Red-Lucy-Engineering/scarlet-8088/renders/scarlet-8088-rev10-front.png

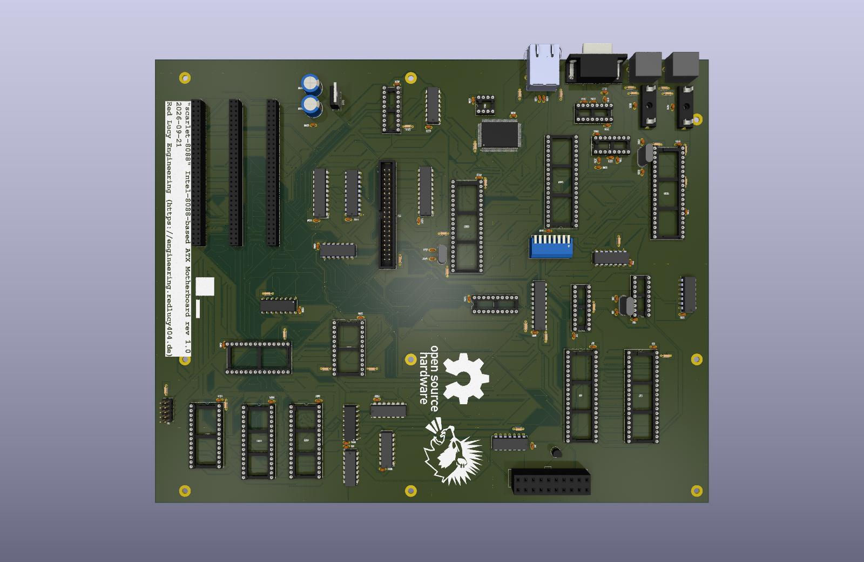
renders/scarlet-8088-rev10-front.png
