Red-Lucy-Engineering/scarlet-8088/README.md

# "scarlet-8088": Intel 8088-based ATX motherboard
