Red-Lucy-Engineering/scarlet-8088/extra/Mini-DIN6-Footprint/Mini-DIN-6P.step

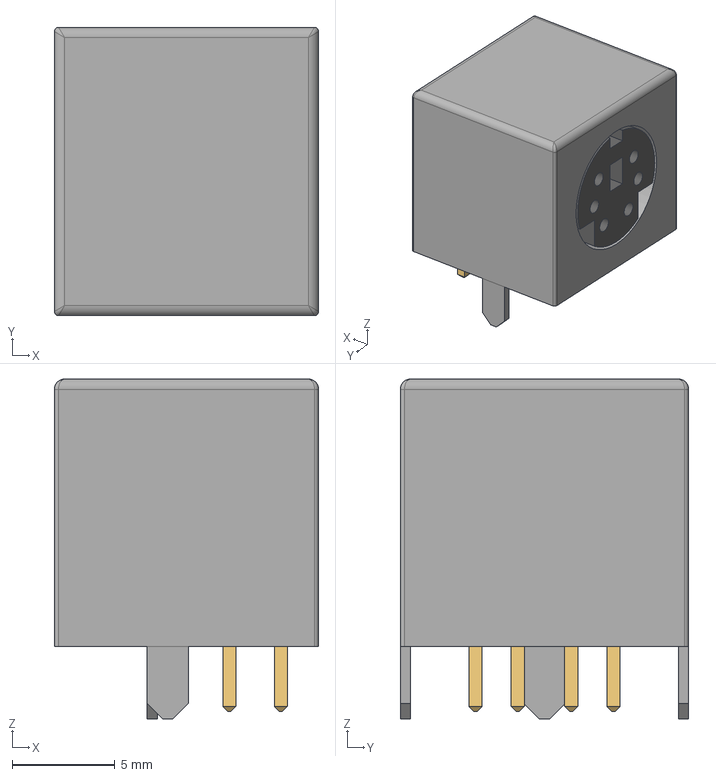
[picture p4: CAD file, 2026-09-21]
extra/Mini-DIN6-Footprint/Mini-DIN-6P.step
12.8 x 14.0 x 16.5 mm
