Red-Lucy-Engineering/scarlet-8088/extra/RJMG1BD3B8K1ANR/RJMG1BD3B8K1ANR--3DModel-STEP-56544.STEP

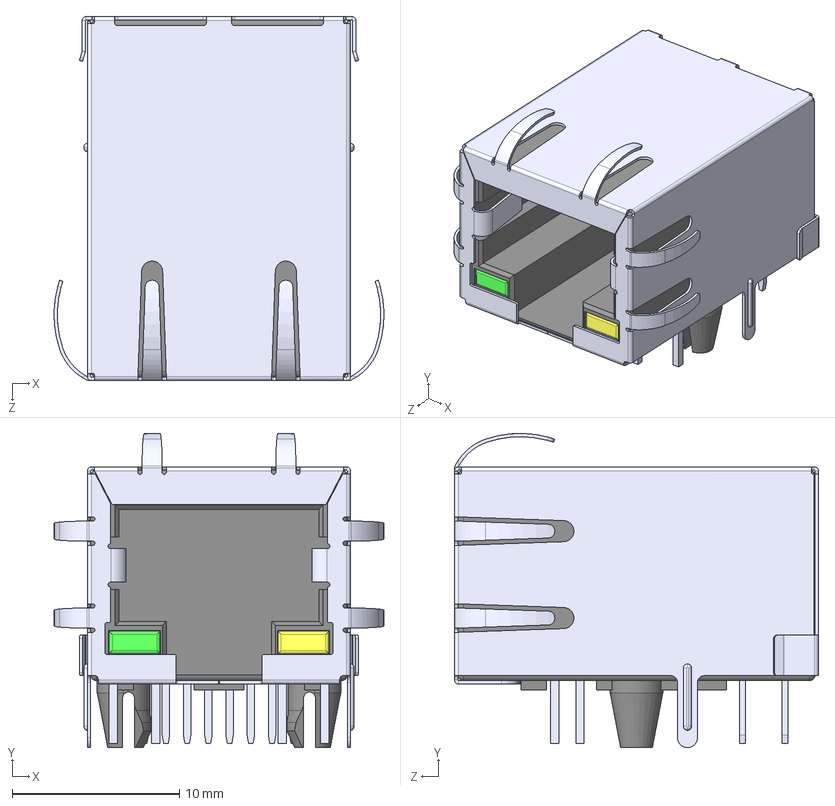
[picture p5: CAD file, 2026-09-21]
extra/RJMG1BD3B8K1ANR/RJMG1BD3B8K1ANR--3DModel-STEP-56544.STEP
19.7 x 18.8 x 21.8 mm
