Red-Lucy-Engineering/scarlet-8088/schematics/scarlet-8088.pdf

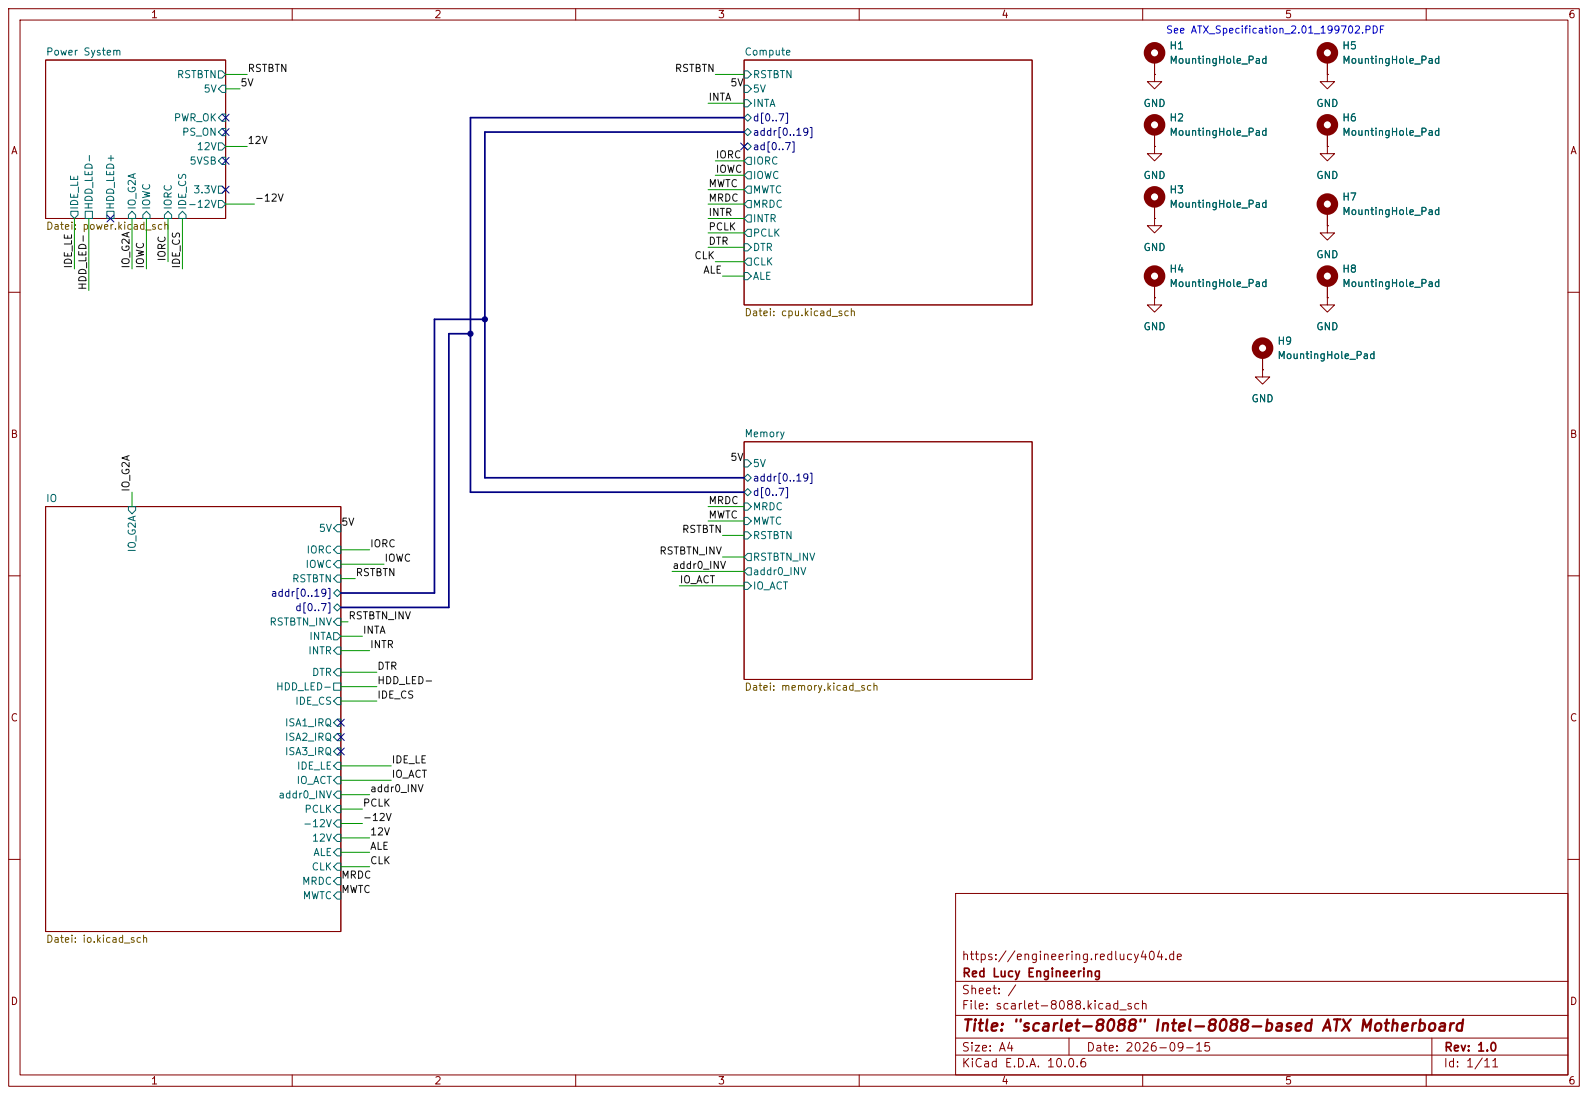
[picture p6: page 1]

ALE CLK MRDC MWTC

https://engineering.redlucy404.de
Red Lucy Engineering
Sheet: /
File: scarlet-8088.kicad_sch
Title: "scarlet-8088" Intel-8088-based ATX Motherboard

Size: A4 | Rev: 1.0
KiCad E.D.A. 10.0.6 | Id: 1/11

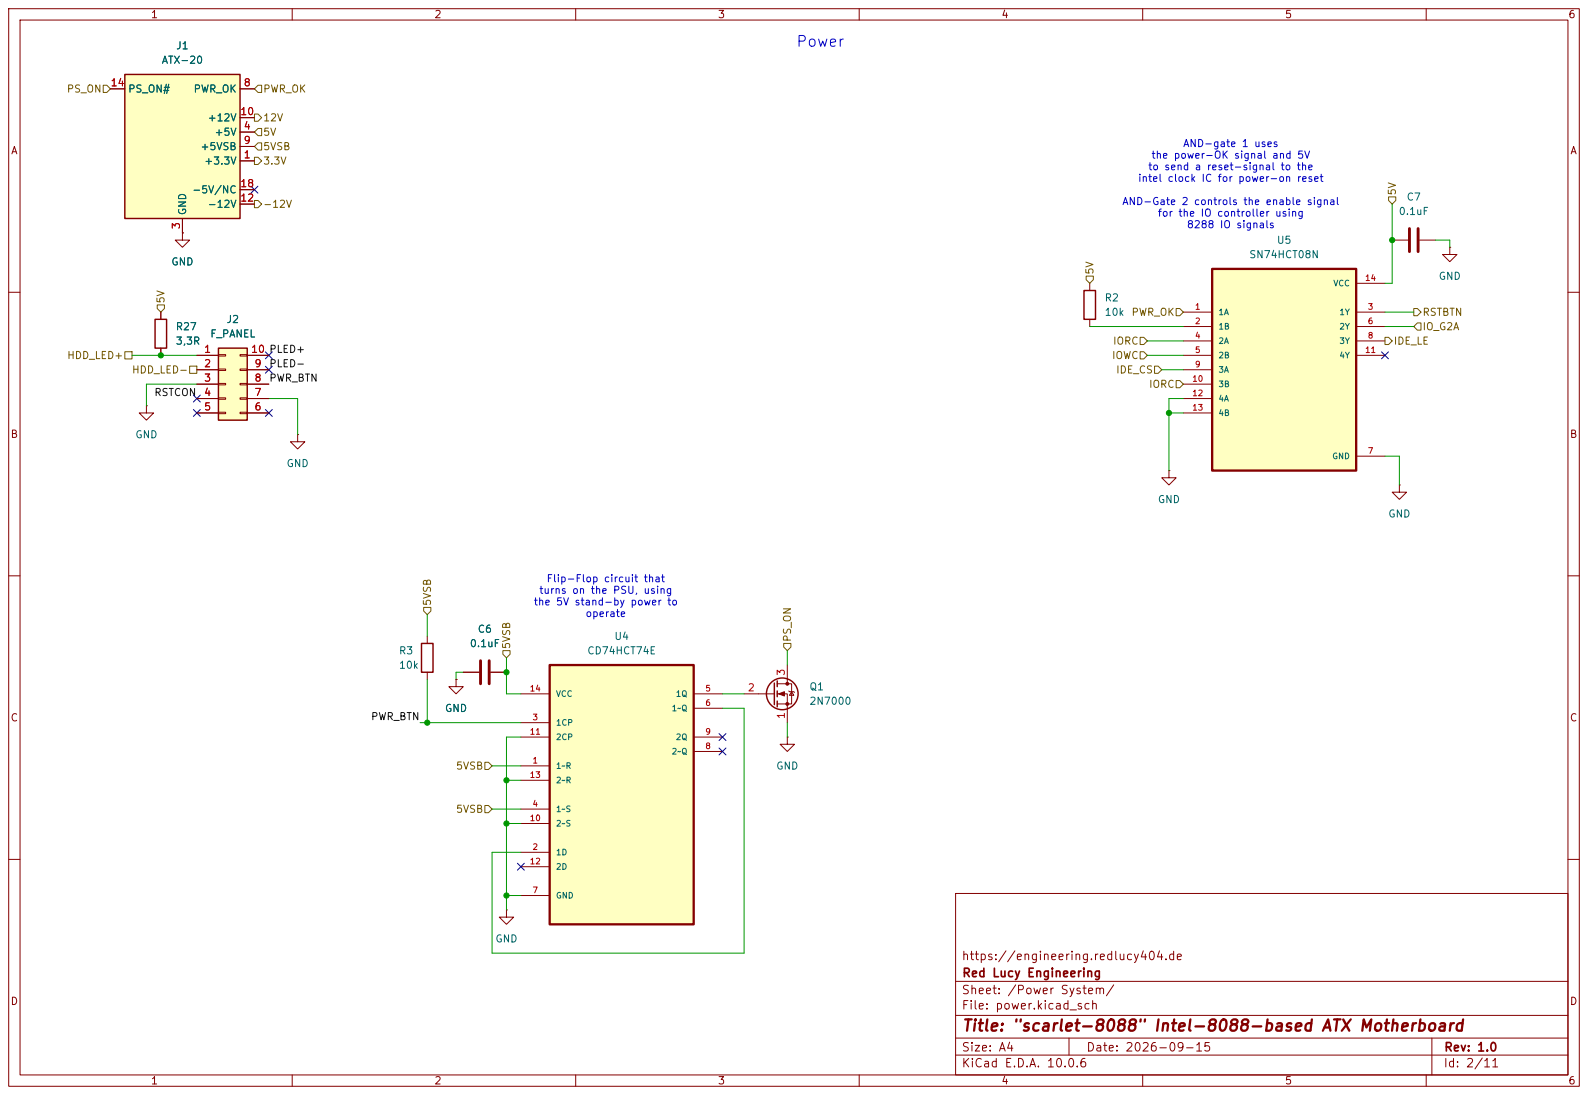
[picture p7: page 2]

AND-gate 1 uses
the power-OK signal and 5V
to send a reset-signal to the

intel clock IC for power-on reset AND-Gate 2 controls the enable signal for the IO controller using 8288 IO signals C6

Flip-Flop circuit that
turns on the PSU, using
the 5V stand-by power to

https://engineering.redlucy404.de
Red Lucy Engineering
Sheet: /Power System/
File: power.kicad_sch
Title: "scarlet-8088" Intel-8088-based ATX Motherboard

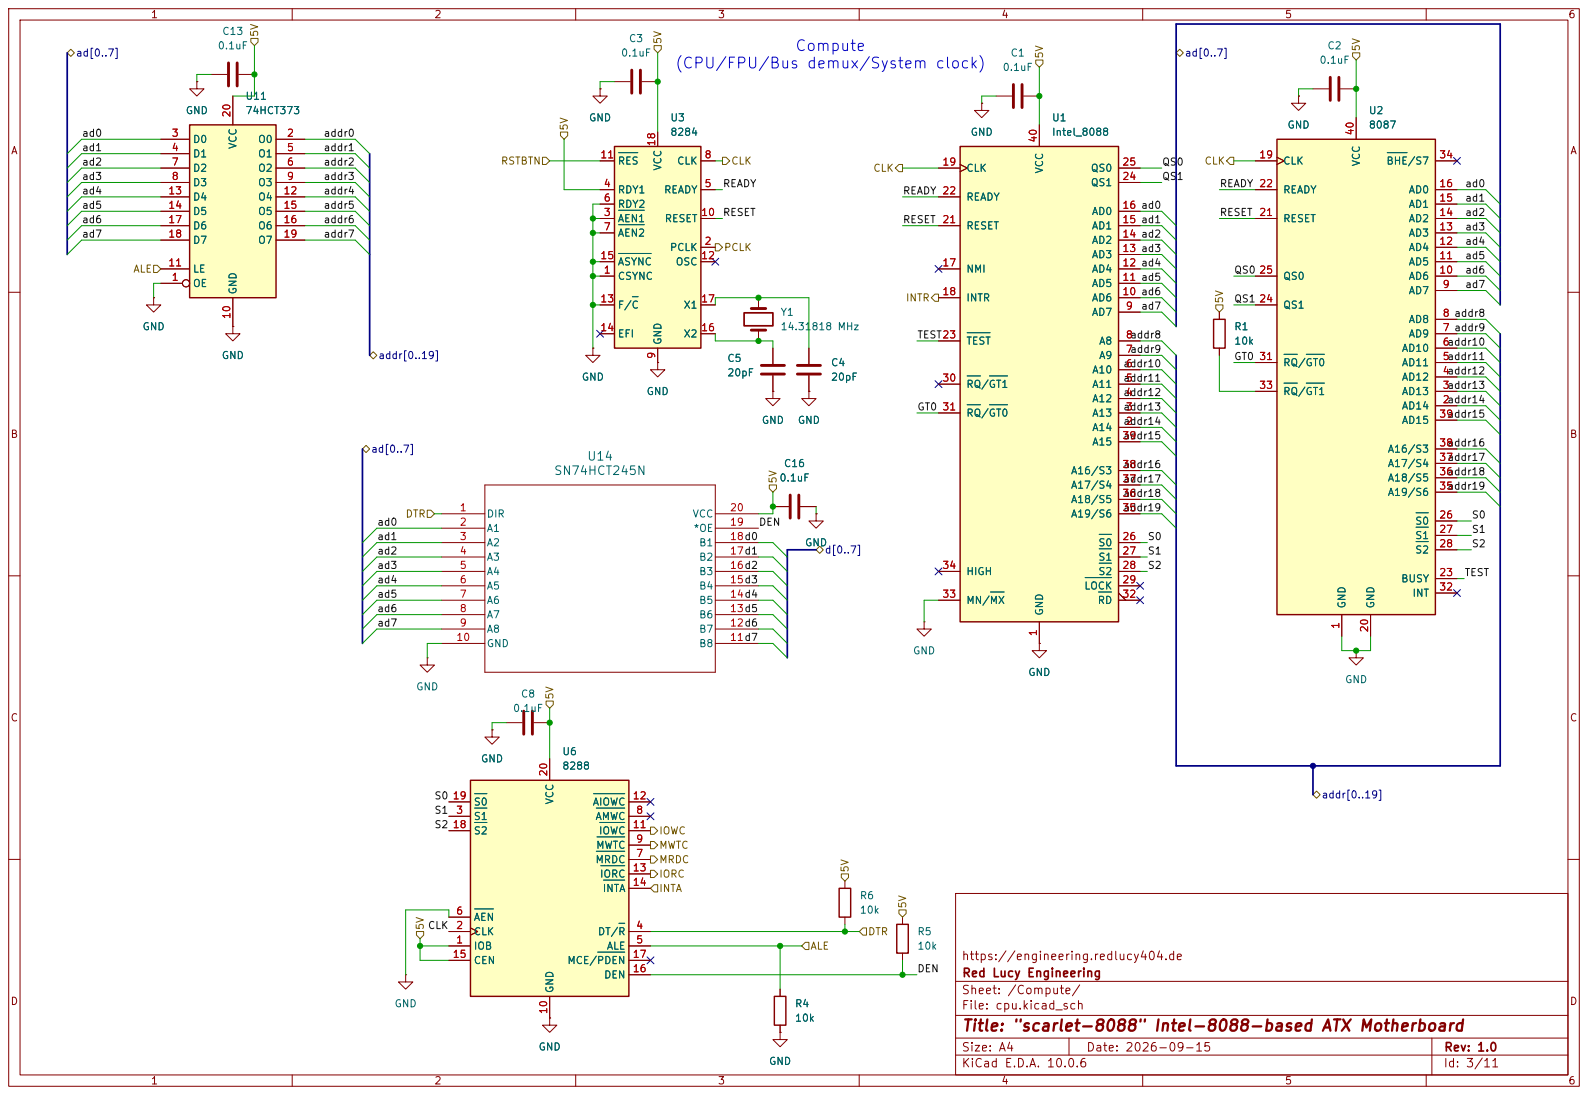
[picture p8: page 3]

(CPU/FPU/Bus demux/System clock)

https://engineering.redlucy404.de
Red Lucy Engineering
Sheet: /Compute/
File: cpu.kicad_sch
Title: "scarlet-8088" Intel-8088-based ATX Motherboard

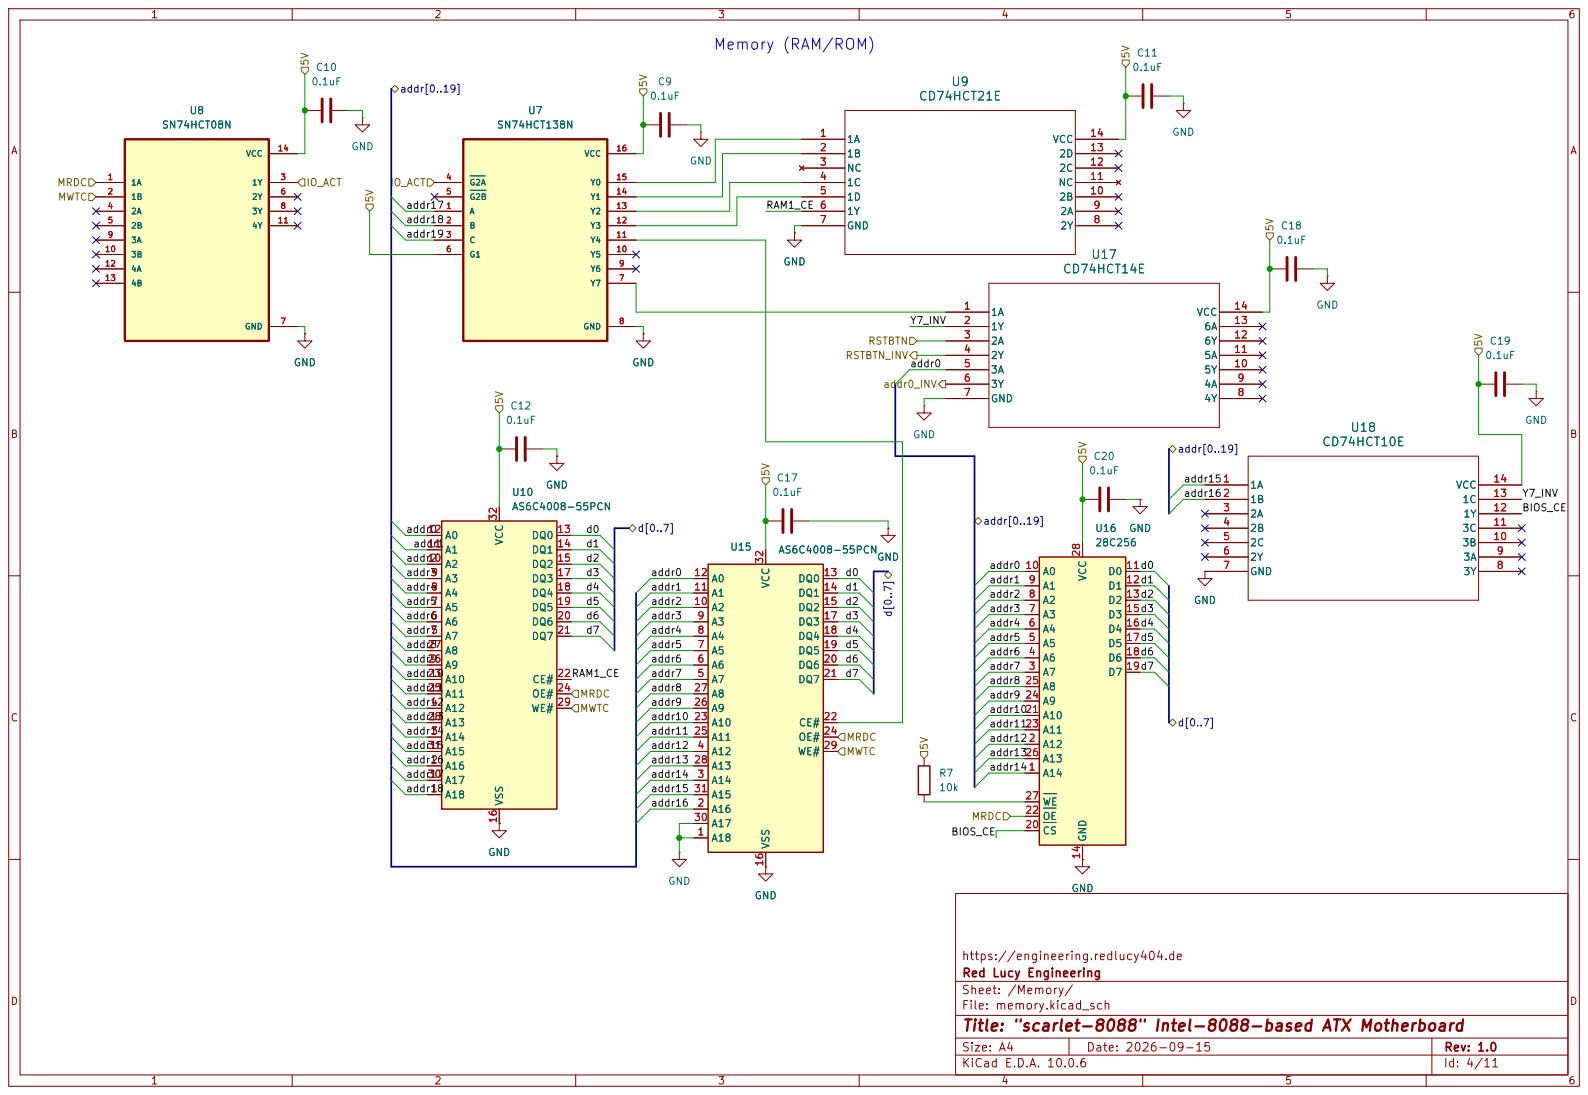
[picture p9: page 4]

https://engineering.redlucy404.de
Red Lucy Engineering
Sheet: /Memory/
File: memory.kicad_sch
Title: "scarlet-8088" Intel-8088-based ATX Motherboard

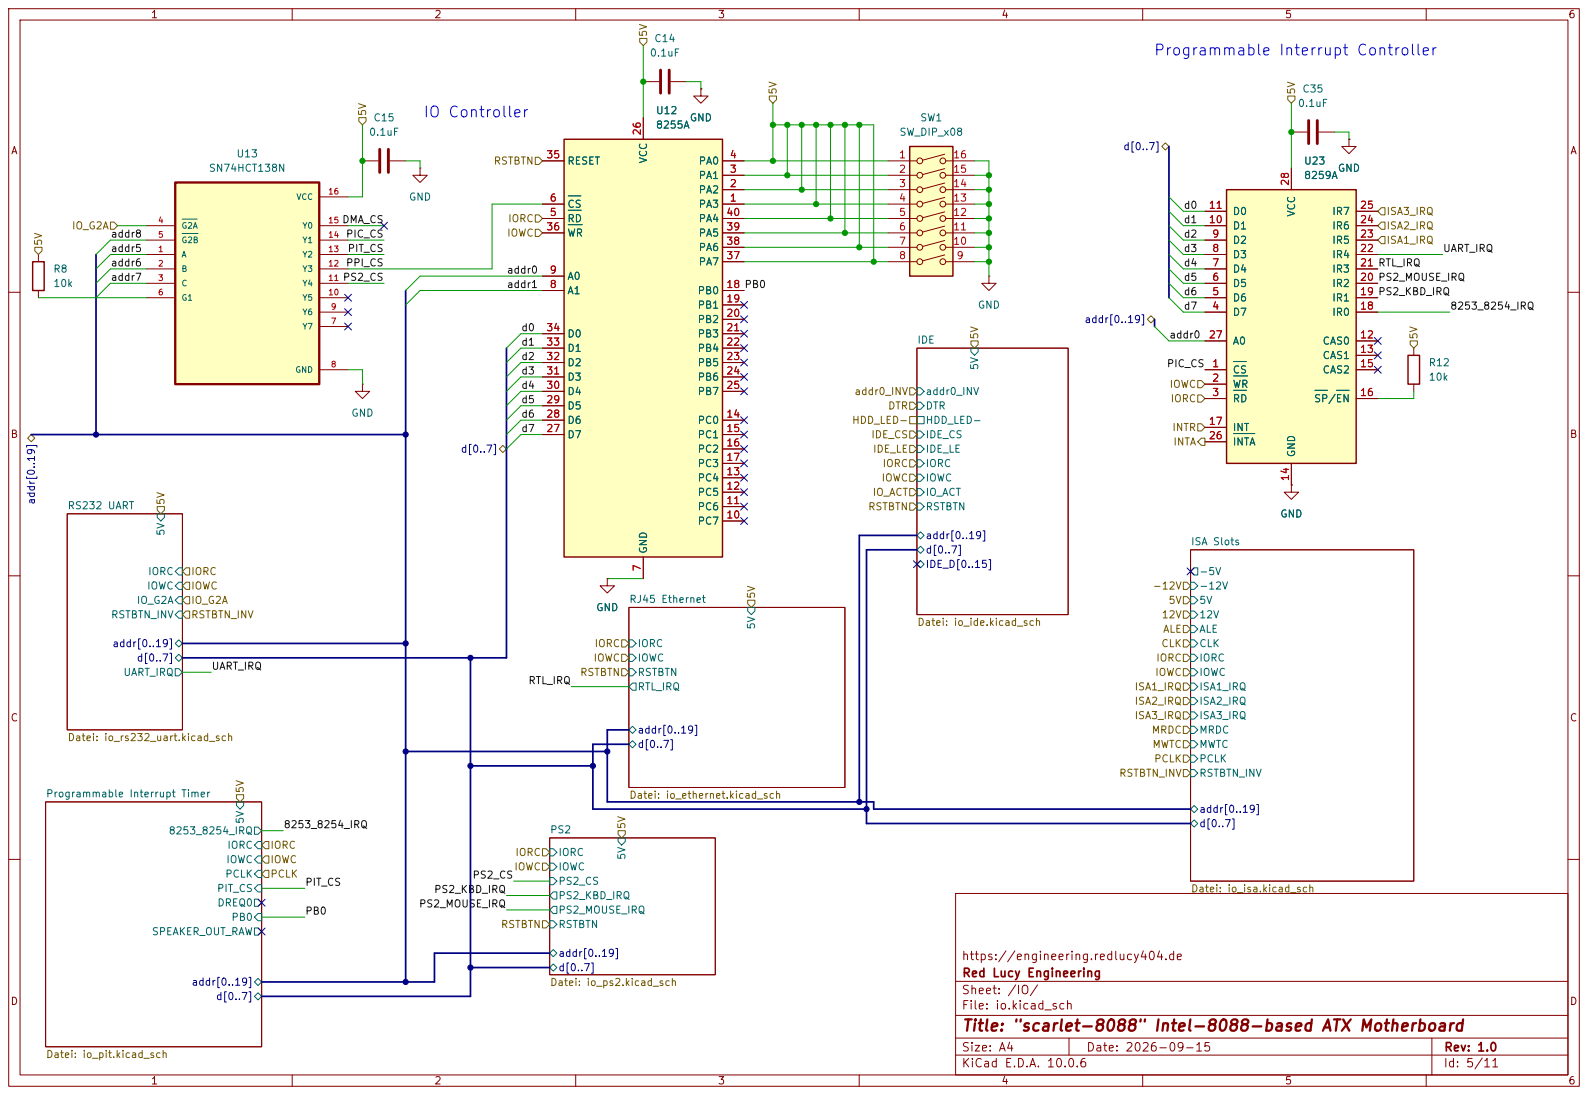
[picture p10: page 5]

6 | ALE 5V

ISA Slots Datei: io_isa.kicad_sch 5V addr0_INV DTR HDD_LED-

https://engineering.redlucy404.de
Red Lucy Engineering
Sheet: /IO/
File: io.kicad_sch
Title: "scarlet-8088" Intel-8088-based ATX Motherboard

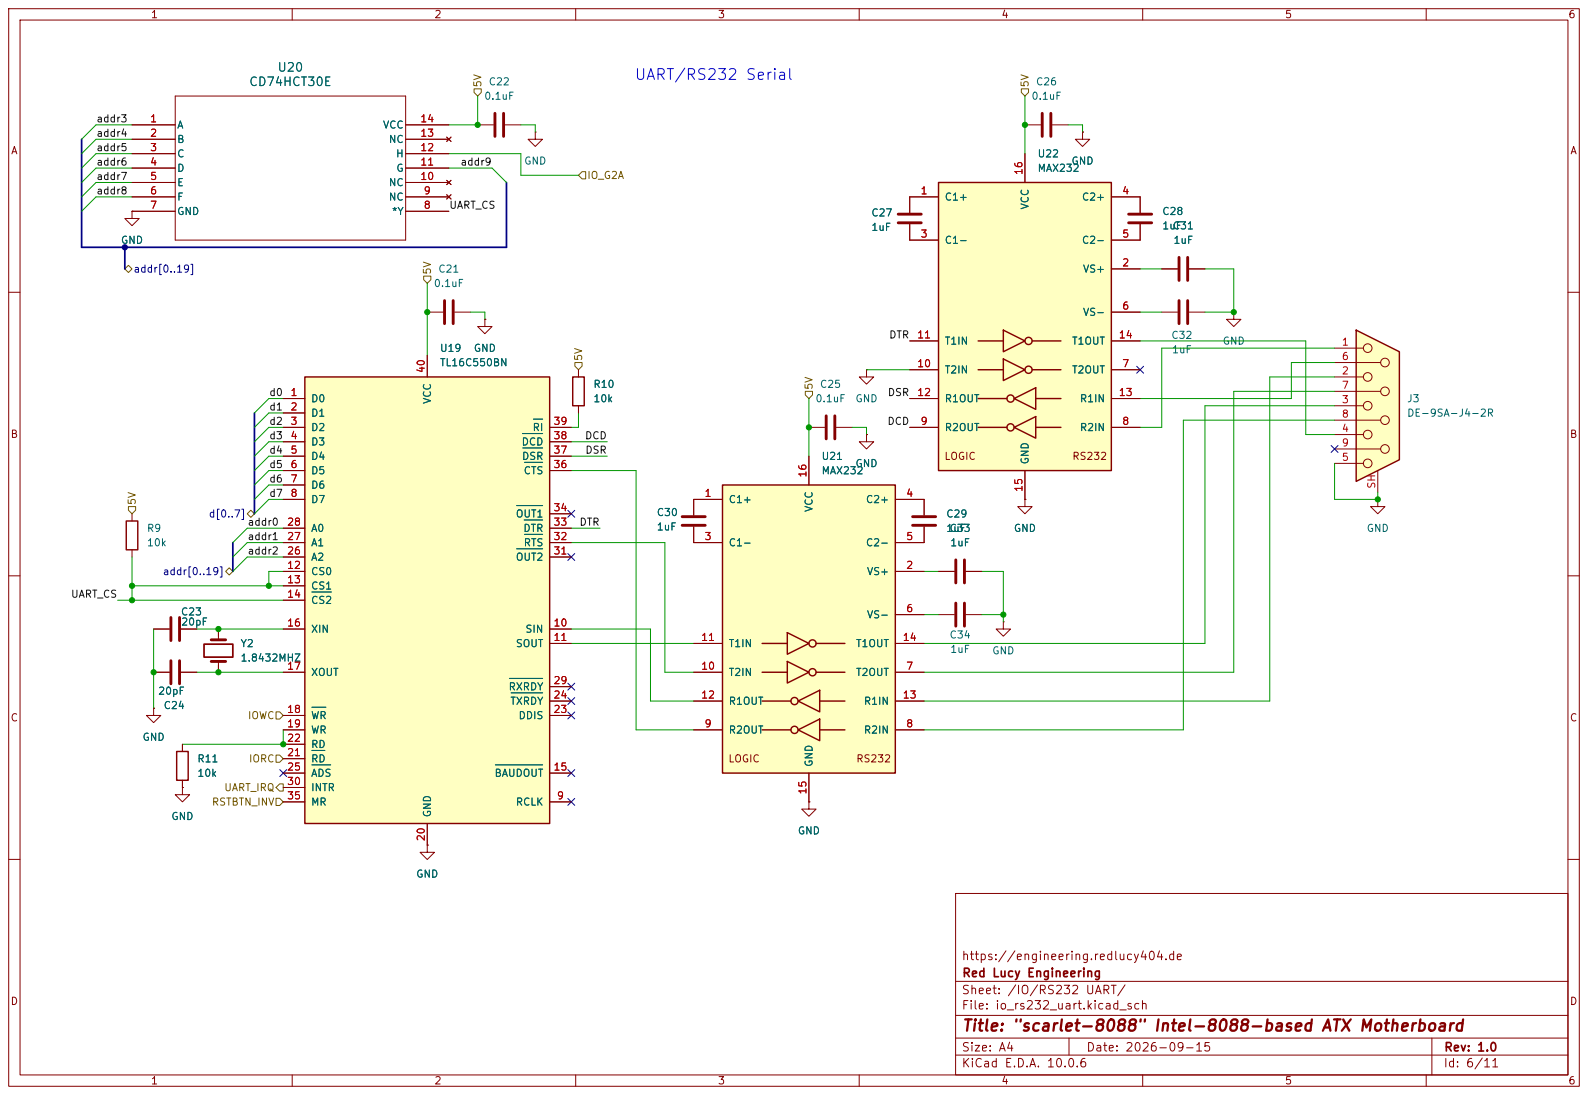
[picture p11: page 6]

https://engineering.redlucy404.de
Red Lucy Engineering
Sheet: /IO/RS232 UART/
File: io_rs232_uart.kicad_sch
Title: "scarlet-8088" Intel-8088-based ATX Motherboard

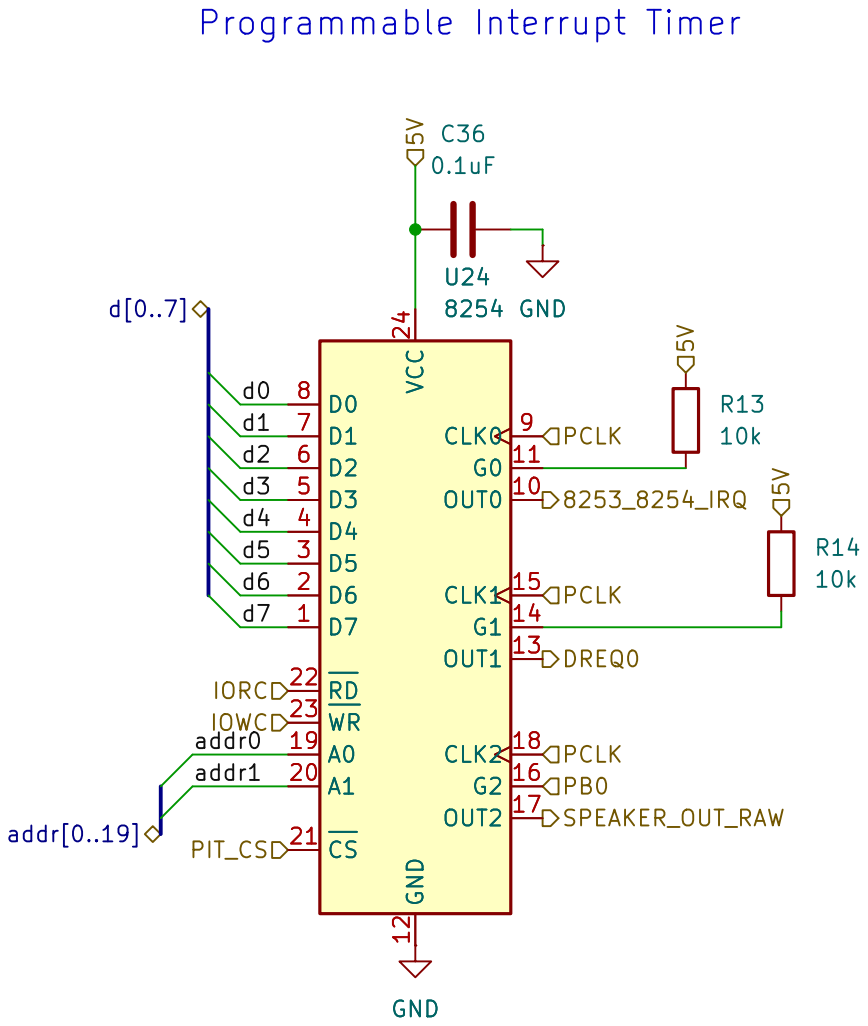
[picture p12: page 7]

https://engineering.redlucy404.de
Red Lucy Engineering
Sheet: /IO/Programmable Interrupt Timer/
File: io_pit.kicad_sch
Title: "scarlet-8088" Intel-8088-based ATX Motherboard

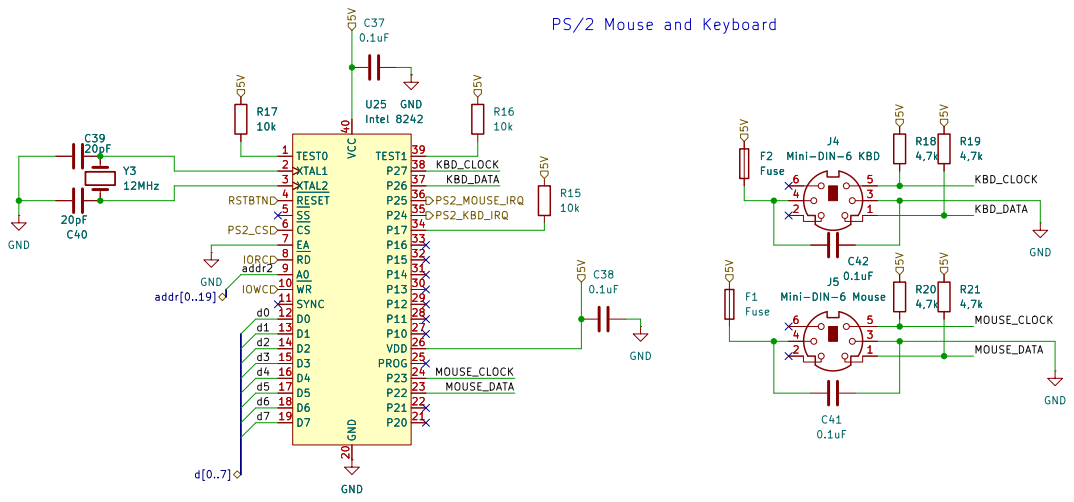
[picture p13: page 8]

https://engineering.redlucy404.de
Red Lucy Engineering
Sheet: /IO/PS2/
File: io_ps2.kicad_sch
Title: "scarlet-8088" Intel-8088-based ATX Motherboard

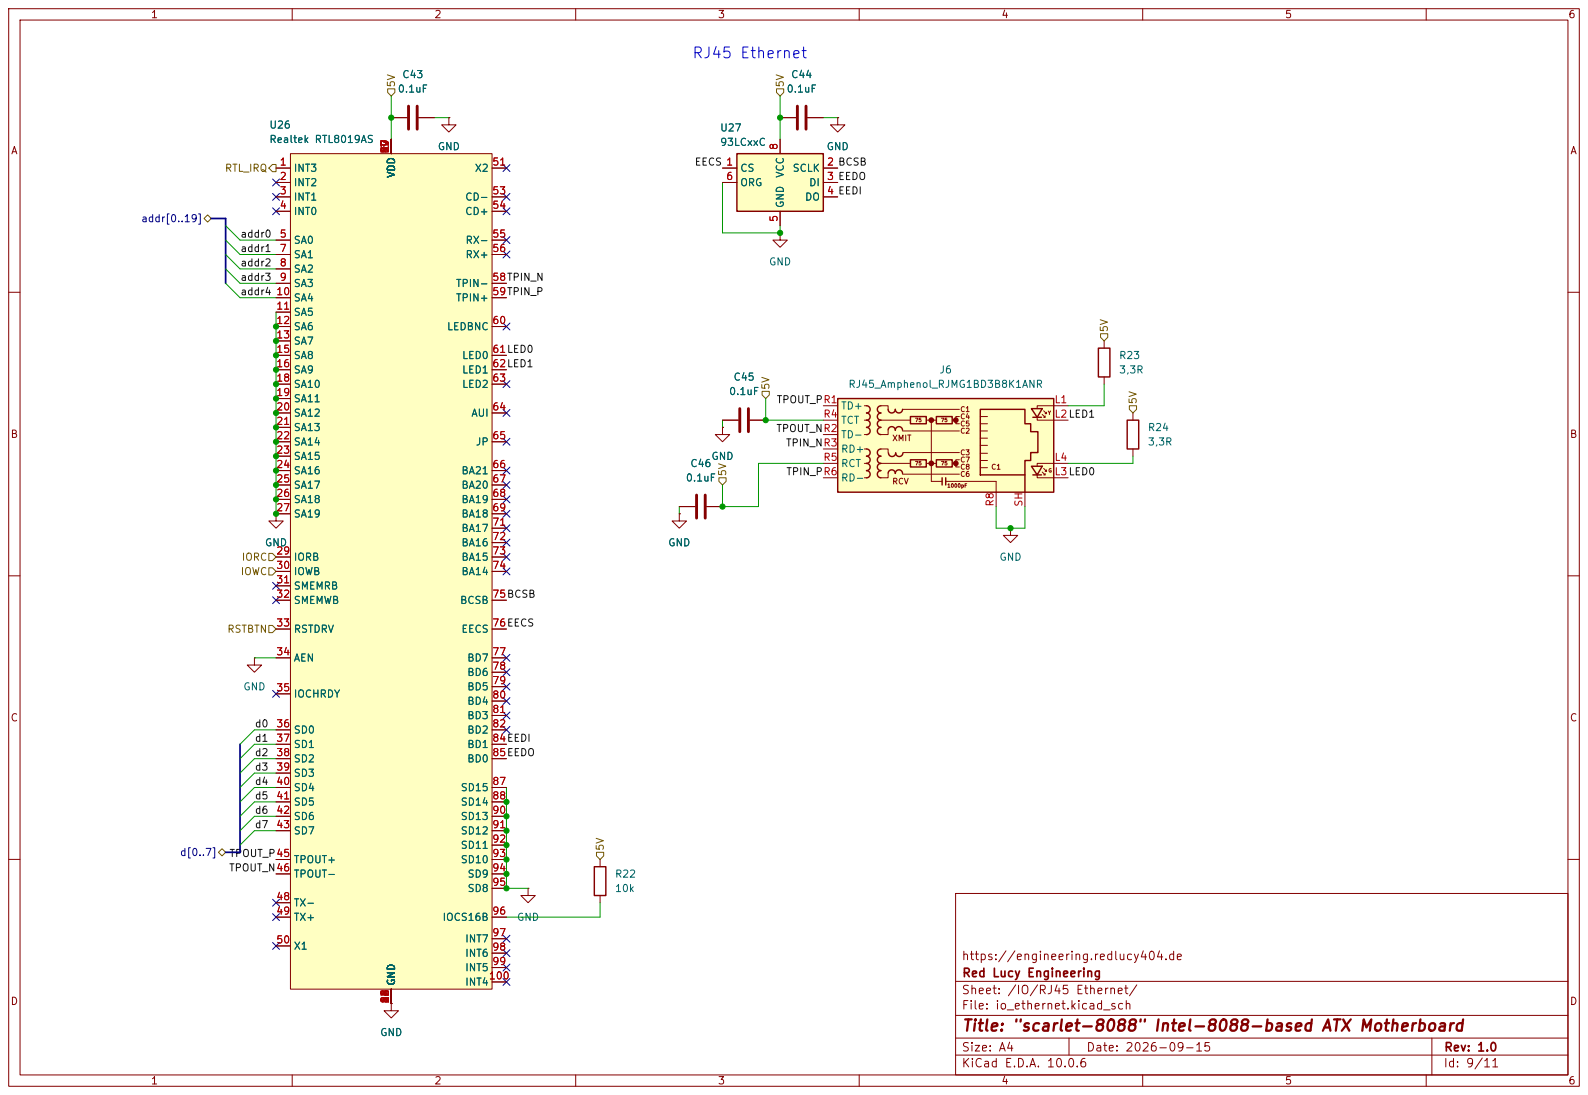
[picture p14: page 9]

https://engineering.redlucy404.de
Red Lucy Engineering
Sheet: /IO/RJ45 Ethernet/
File: io_ethernet.kicad_sch
Title: "scarlet-8088" Intel-8088-based ATX Motherboard

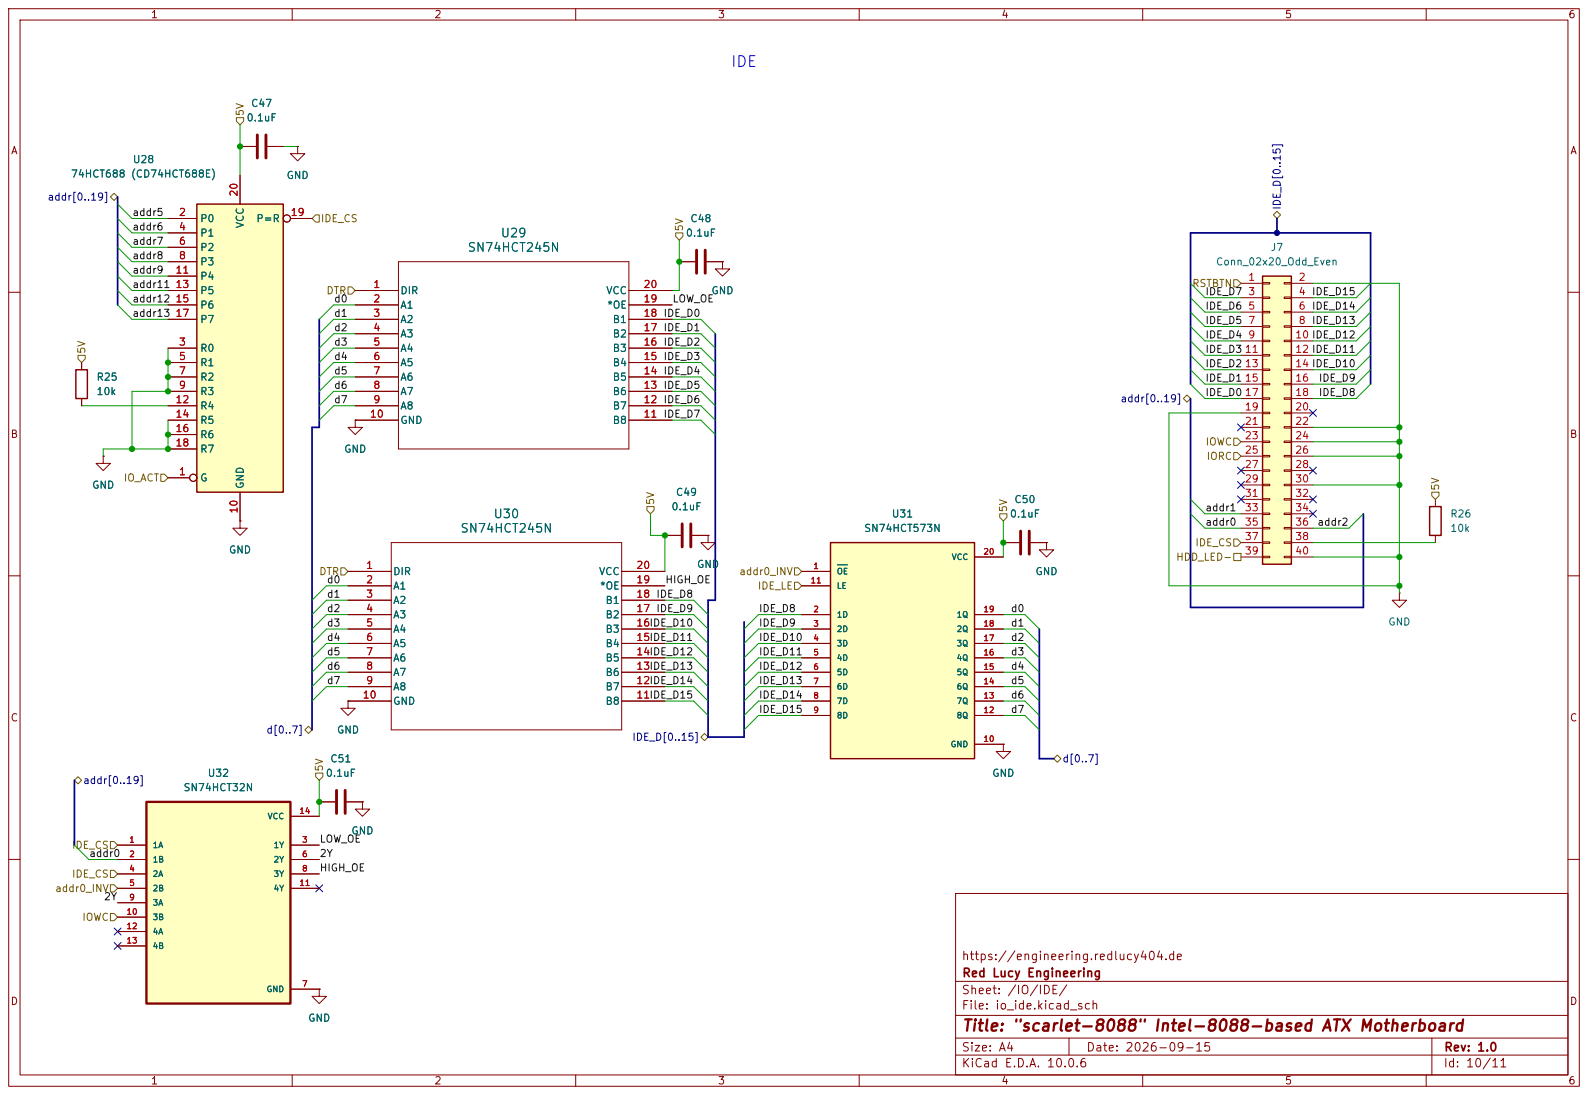
[picture p15: page 10]

https://engineering.redlucy404.de
Red Lucy Engineering
Sheet: /IO/IDE/
File: io_ide.kicad_sch
Title: "scarlet-8088" Intel-8088-based ATX Motherboard

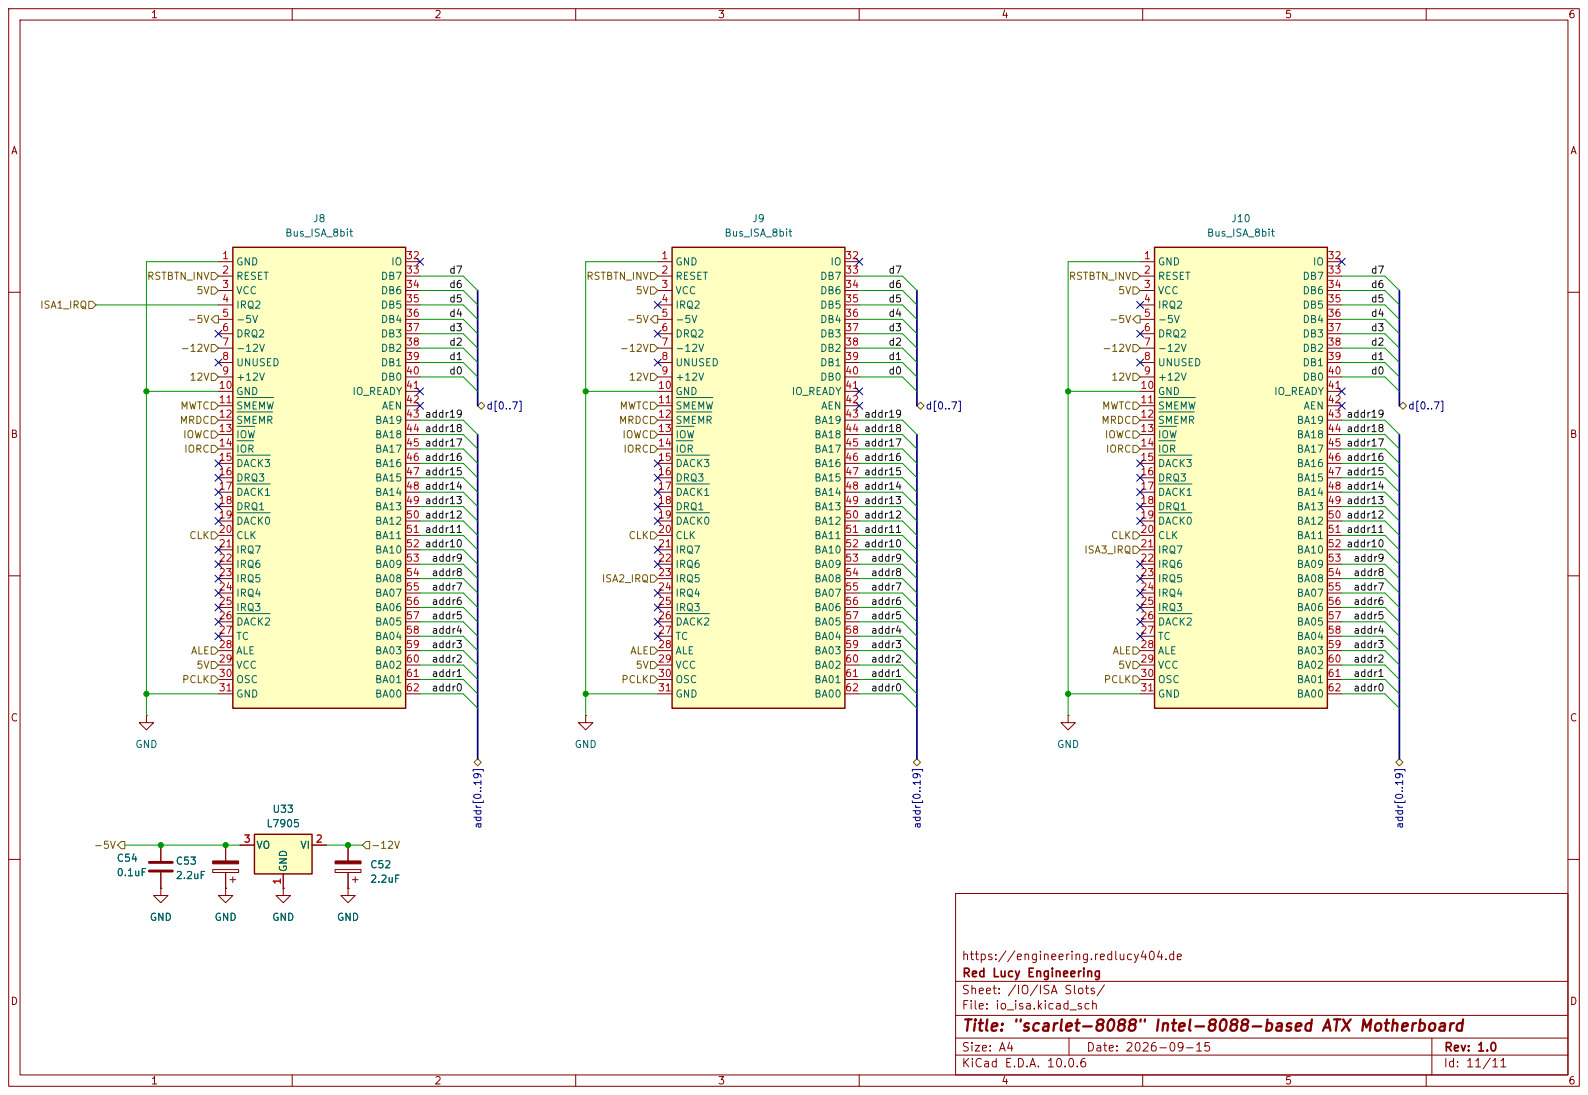
[picture p16: page 11]

https://engineering.redlucy404.de
Red Lucy Engineering
Sheet: /IO/ISA Slots/
File: io_isa.kicad_sch
Title: "scarlet-8088" Intel-8088-based ATX Motherboard
