Red-Lucy-Engineering/scarlet-8088/scarlet-8088.kicad_pcb

## KiCad design scarlet-8088.kicad_pcb (2026-09-21)

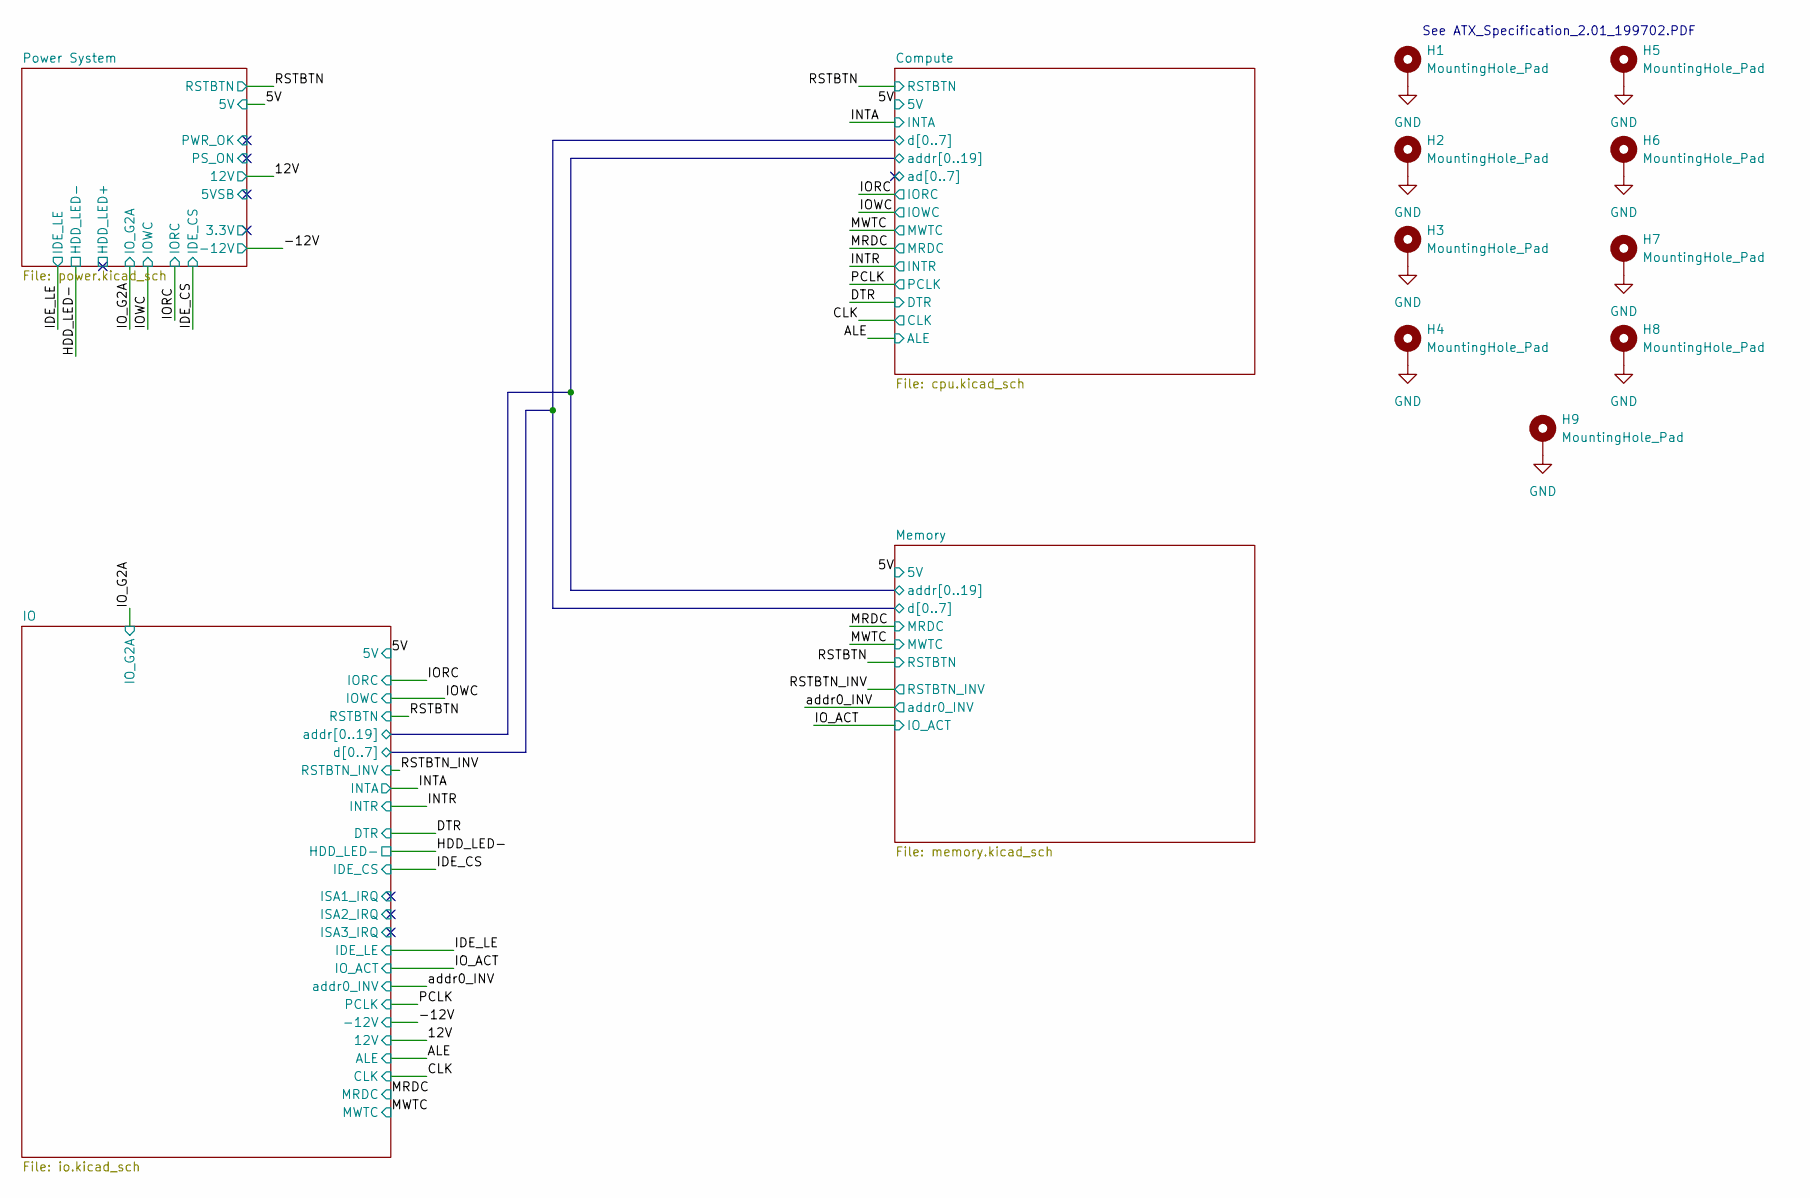
[picture p17: schematic scarlet-8088.kicad_sch, ${TITLE}]

Parts:
H1, H2, H3, H4, H5, H6, H7, H8, H9: MountingHole_Pad; MountingHole_3.2mm_M3_Pad_TopBottom

Connections:
GND: H1.1 (1_1), H2.1 (1_1), H3.1 (1_1), H4.1 (1_1), H5.1 (1_1), H6.1 (1_1), H7.1 (1_1), H8.1 (1_1), H9.1 (1_1); also elsewhere on the board

Notes on the sheet:
See ATX_Specification_2.01_199702.PDF

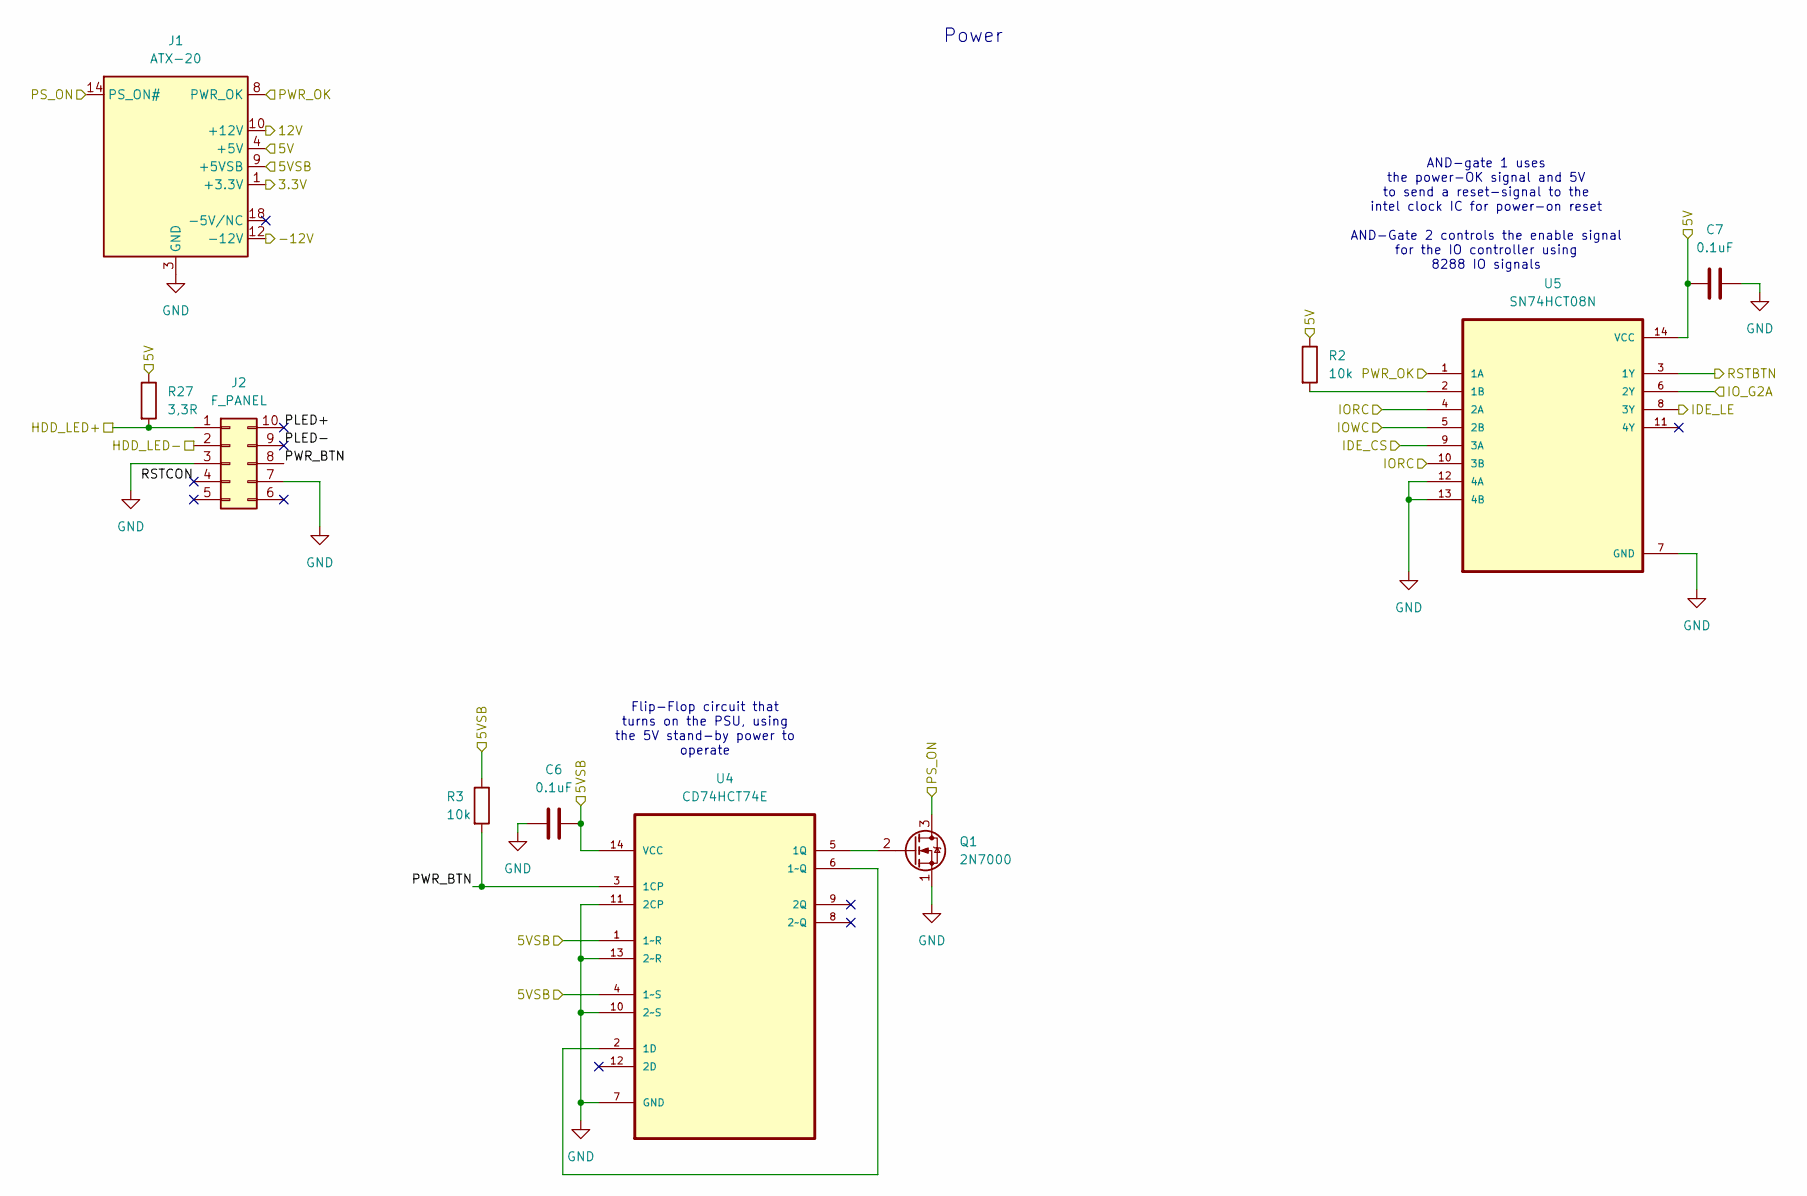
[picture p18: schematic power.kicad_sch, ${TITLE}]

Parts:
C6, C7: 0.1uF; C_Disc_D3.0mm_W1.6mm_P2.50mm
J1: ATX-20; Molex_Mini-Fit_Jr_5566-20A_2x10_P4.20mm_Vertical
J2: F_PANEL; PinHeader_2x05_P2.54mm_Vertical
Q1: 2N7000; TO-92_Inline
R2, R3: 10k; R_Axial_DIN0204_L3.6mm_D1.6mm_P5.08mm_Horizontal
R27: 3,3R; R_Axial_DIN0204_L3.6mm_D1.6mm_P5.08mm_Horizontal
U4: CD74HCT74E; DIP254P762X508-14; MPN CD74HCT74E
U5: SN74HCT08N; DIP794W45P254L1969H508Q14

Connections:
/5V: C7.1, J1.4 (+5V), J1.6 (+5V), J1.19 (+5V), J1.20 (+5V), R2.1, R27.1, U5.14 (VCC); also elsewhere on the board
/12V: J1.10 (+12V); also elsewhere on the board
/-12V: J1.12 (-12V); also elsewhere on the board
/HDD_LED-: J2.2; also elsewhere on the board
/IDE_CS: U5.9 (3A); also elsewhere on the board
/IDE_LE: U5.8 (3Y); also elsewhere on the board
/IORC: U5.4 (2A), U5.10 (3B); also elsewhere on the board
/IOWC: U5.5 (2B); also elsewhere on the board
/IO_G2A: U5.6 (2Y); also elsewhere on the board
/Power System/5VSB: C6.2, J1.9 (+5VSB), R3.1, U4.1 (1~R), U4.4 (1~S), U4.14 (VCC)
/Power System/HDD_LED+: J2.1, R27.2
/Power System/PLED+: J2.10
/Power System/PLED-: J2.9
/Power System/PS_ON: J1.14 (PS_ON#), Q1.3 (D)
/Power System/PWR_BTN: J2.8, R3.2, U4.3 (1CP)
/Power System/PWR_OK: J1.8 (PWR_OK), U5.1 (1A)
/Power System/RSTCON: J2.4
/RSTBTN: U5.3 (1Y); also elsewhere on the board
GND: C6.1, C7.2, J1.3 (GND), J1.5 (GND), J1.7 (GND), J1.13 (GND), J1.15 (GND), J1.16 (GND), J1.17 (GND), J2.3, J2.7, Q1.1 (S), U4.7 (GND), U4.10 (2~S), U4.11 (2CP), U4.13 (2~R), U5.7 (GND), U5.12 (4A), U5.13 (4B); also elsewhere on the board
unnamed: Q1.2 (G), U4.5 (1Q)
unnamed: U4.2 (1D), U4.6 (1~Q)
unnamed: R2.2, U5.2 (1B)

Notes on the sheet:
Power
AND-gate 1 uses the power-OK signal and 5V to send a reset-signal to the intel clock IC for power-on reset AND-Gate 2 controls the enable signal for the IO controller using 8288 IO signals
Flip-Flop circuit that turns on the PSU, using the 5V stand-by power to operate

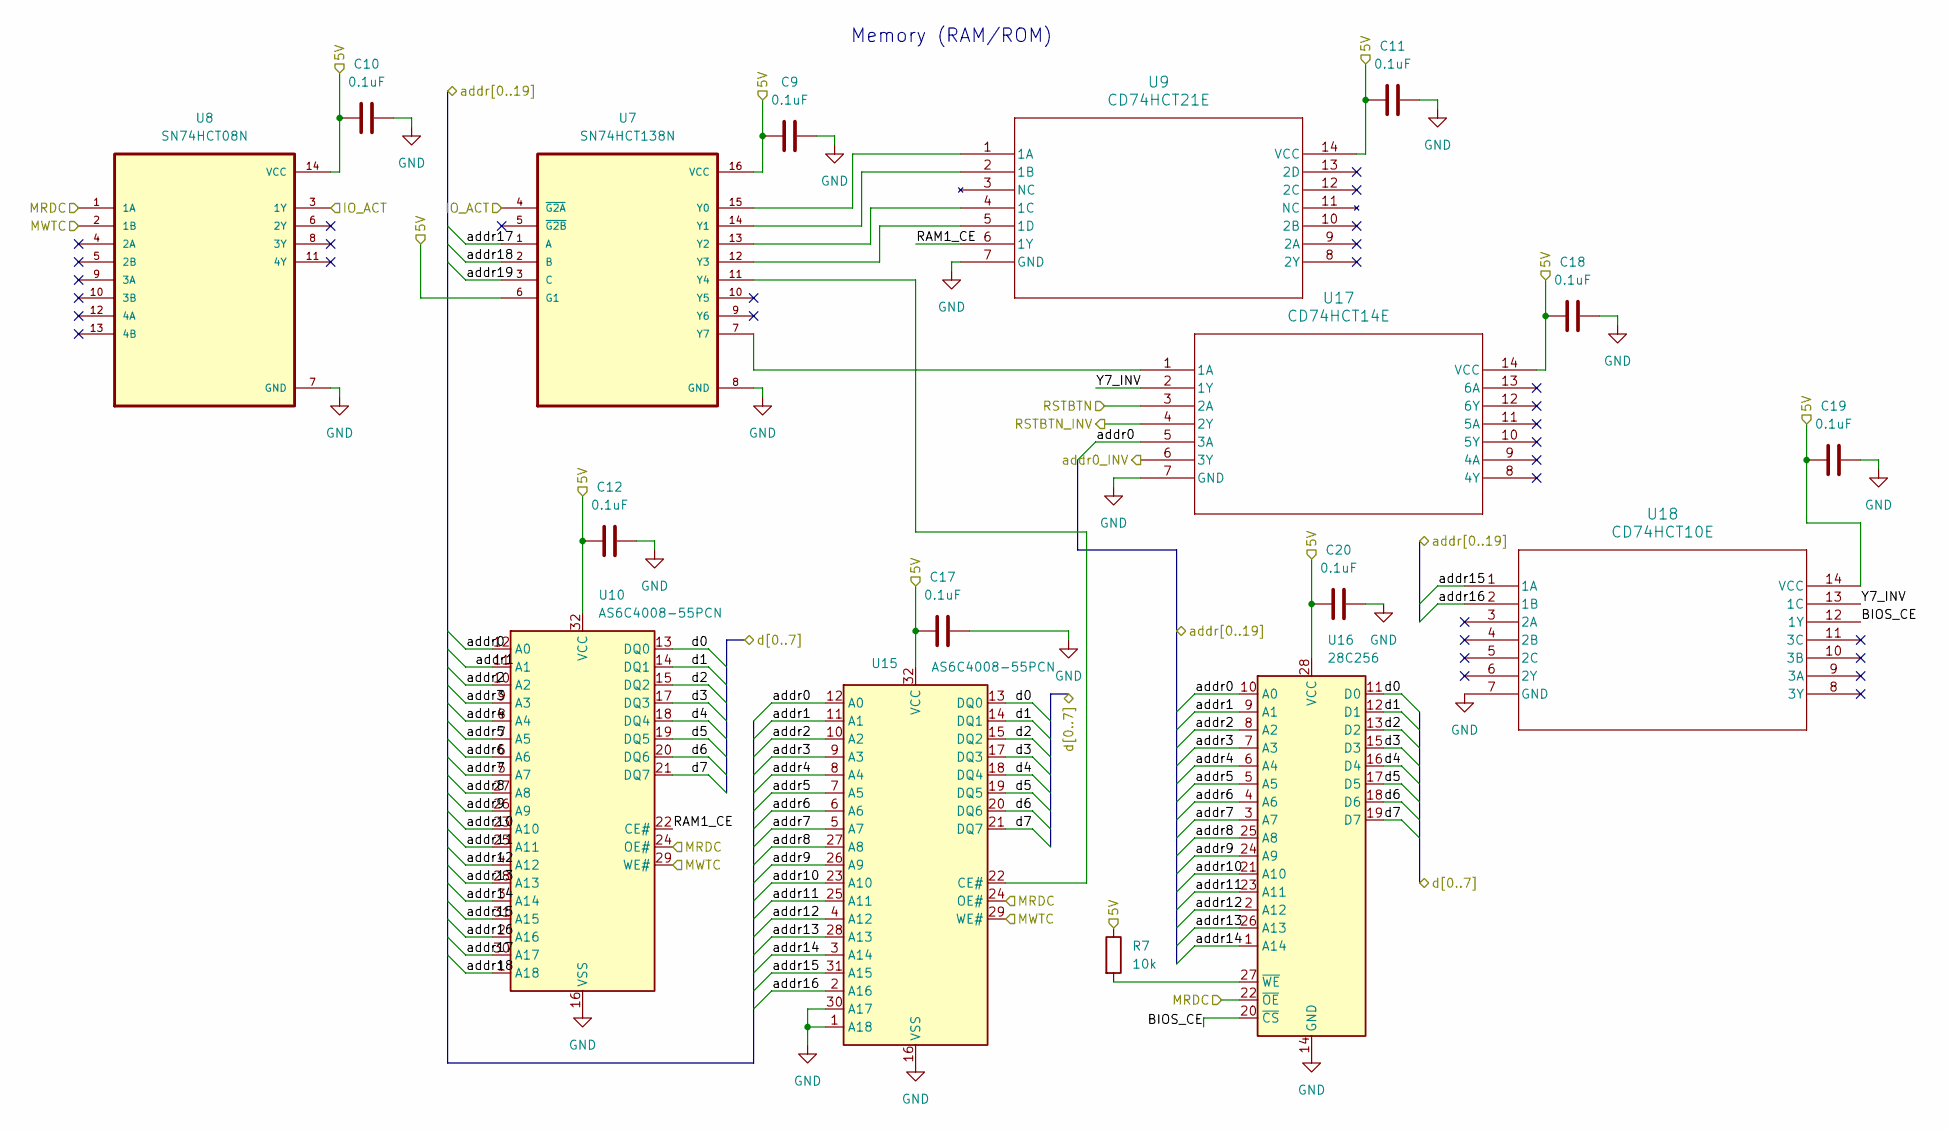
[picture p19: schematic memory.kicad_sch, ${TITLE}]

Parts:
C9, C10, C11, C12, C17, C18, C19, C20: 0.1uF; C_Disc_D3.0mm_W1.6mm_P2.50mm
R7: 10k; R_Axial_DIN0204_L3.6mm_D1.6mm_P5.08mm_Horizontal
U7: SN74HCT138N; DIP794W45P254L1969H508Q16
U8: SN74HCT08N; DIP794W45P254L1969H508Q14
U9: CD74HCT21E; N14
U10, U15: AS6C4008-55PCN; DIP-32_W15.24mm_Socket
U16: 28C256; DIP-28_W15.24mm_Socket
U17: CD74HCT14E
U18: CD74HCT10E; N14

Connections:
/5V: C9.2, C10.1, C11.2, C12.1, C17.1, C18.2, C19.2, C20.1, R7.1, U7.6 (G1), U7.16 (VCC), U8.14 (VCC), U9.14 (VCC), U10.32 (VCC), U15.32 (VCC), U16.28 (VCC), U17.14 (VCC), U18.14 (VCC); also elsewhere on the board
/Compute/addr0: U10.12 (A0), U15.12 (A0), U16.10 (A0), U17.5 (3A); also elsewhere on the board
/Compute/addr1: U10.11 (A1), U15.11 (A1), U16.9 (A1); also elsewhere on the board
/Compute/addr2: U10.10 (A2), U15.10 (A2), U16.8 (A2); also elsewhere on the board
/Compute/addr3: U10.9 (A3), U15.9 (A3), U16.7 (A3); also elsewhere on the board
/Compute/addr4: U10.8 (A4), U15.8 (A4), U16.6 (A4); also elsewhere on the board
/Compute/addr5: U10.7 (A5), U15.7 (A5), U16.5 (A5); also elsewhere on the board
/Compute/addr6: U10.6 (A6), U15.6 (A6), U16.4 (A6); also elsewhere on the board
/Compute/addr7: U10.5 (A7), U15.5 (A7), U16.3 (A7); also elsewhere on the board
/Compute/addr8: U10.27 (A8), U15.27 (A8), U16.25 (A8); also elsewhere on the board
/Compute/addr9: U10.26 (A9), U15.26 (A9), U16.24 (A9); also elsewhere on the board
/Compute/addr10: U10.23 (A10), U15.23 (A10), U16.21 (A10); also elsewhere on the board
/Compute/addr11: U10.25 (A11), U15.25 (A11), U16.23 (A11); also elsewhere on the board
/Compute/addr12: U10.4 (A12), U15.4 (A12), U16.2 (A12); also elsewhere on the board
/Compute/addr13: U10.28 (A13), U15.28 (A13), U16.26 (A13); also elsewhere on the board
/Compute/addr14: U10.3 (A14), U15.3 (A14), U16.1 (A14); also elsewhere on the board
/Compute/addr15: U10.31 (A15), U15.31 (A15), U18.1 (1A); also elsewhere on the board
/Compute/addr16: U10.2 (A16), U15.2 (A16), U18.2 (1B); also elsewhere on the board
/Compute/addr17: U7.1 (A), U10.30 (A17); also elsewhere on the board
/Compute/addr18: U7.2 (B), U10.1 (A18); also elsewhere on the board
/Compute/addr19: U7.3 (C); also elsewhere on the board
/Compute/d0: U10.13 (DQ0), U15.13 (DQ0), U16.11 (D0); also elsewhere on the board
/Compute/d1: U10.14 (DQ1), U15.14 (DQ1), U16.12 (D1); also elsewhere on the board
/Compute/d2: U10.15 (DQ2), U15.15 (DQ2), U16.13 (D2); also elsewhere on the board
/Compute/d3: U10.17 (DQ3), U15.17 (DQ3), U16.15 (D3); also elsewhere on the board
/Compute/d4: U10.18 (DQ4), U15.18 (DQ4), U16.16 (D4); also elsewhere on the board
/Compute/d5: U10.19 (DQ5), U15.19 (DQ5), U16.17 (D5); also elsewhere on the board
/Compute/d6: U10.20 (DQ6), U15.20 (DQ6), U16.18 (D6); also elsewhere on the board
/Compute/d7: U10.21 (DQ7), U15.21 (DQ7), U16.19 (D7); also elsewhere on the board
/IO_ACT: U7.4 (~G2A), U8.3 (1Y); also elsewhere on the board
/MRDC: U8.1 (1A), U10.24 (OE#), U15.24 (OE#), U16.22 (~OE); also elsewhere on the board
/MWTC: U8.2 (1B), U10.29 (WE#), U15.29 (WE#); also elsewhere on the board
/Memory/BIOS_CE: U16.20 (~CS), U18.12 (1Y)
/Memory/RAM1_CE: U9.6 (1Y), U10.22 (CE#)
/Memory/Y7_INV: U17.2 (1Y), U18.13 (1C)
/RSTBTN: U17.3 (2A); also elsewhere on the board
/RSTBTN_INV: U17.4 (2Y); also elsewhere on the board
/addr0_INV: U17.6 (3Y); also elsewhere on the board
GND: C9.1, C10.2, C11.1, C12.2, C17.2, C18.1, C19.1, C20.2, U7.8 (GND), U8.7 (GND), U9.7 (GND), U10.16 (VSS), U15.1 (A18), U15.16 (VSS), U15.30 (A17), U16.14 (GND), U17.7 (GND), U18.7 (GND); also elsewhere on the board
unnamed: U7.15 (Y0), U9.1 (1A)
unnamed: U7.14 (Y1), U9.2 (1B)
unnamed: U7.13 (Y2), U9.4 (1C)
unnamed: U7.12 (Y3), U9.5 (1D)
unnamed: U7.11 (Y4), U15.22 (CE#)
unnamed: R7.2, U16.27 (~WE)
unnamed: U7.7 (Y7), U17.1 (1A)

Notes on the sheet:
Memory (RAM/ROM)

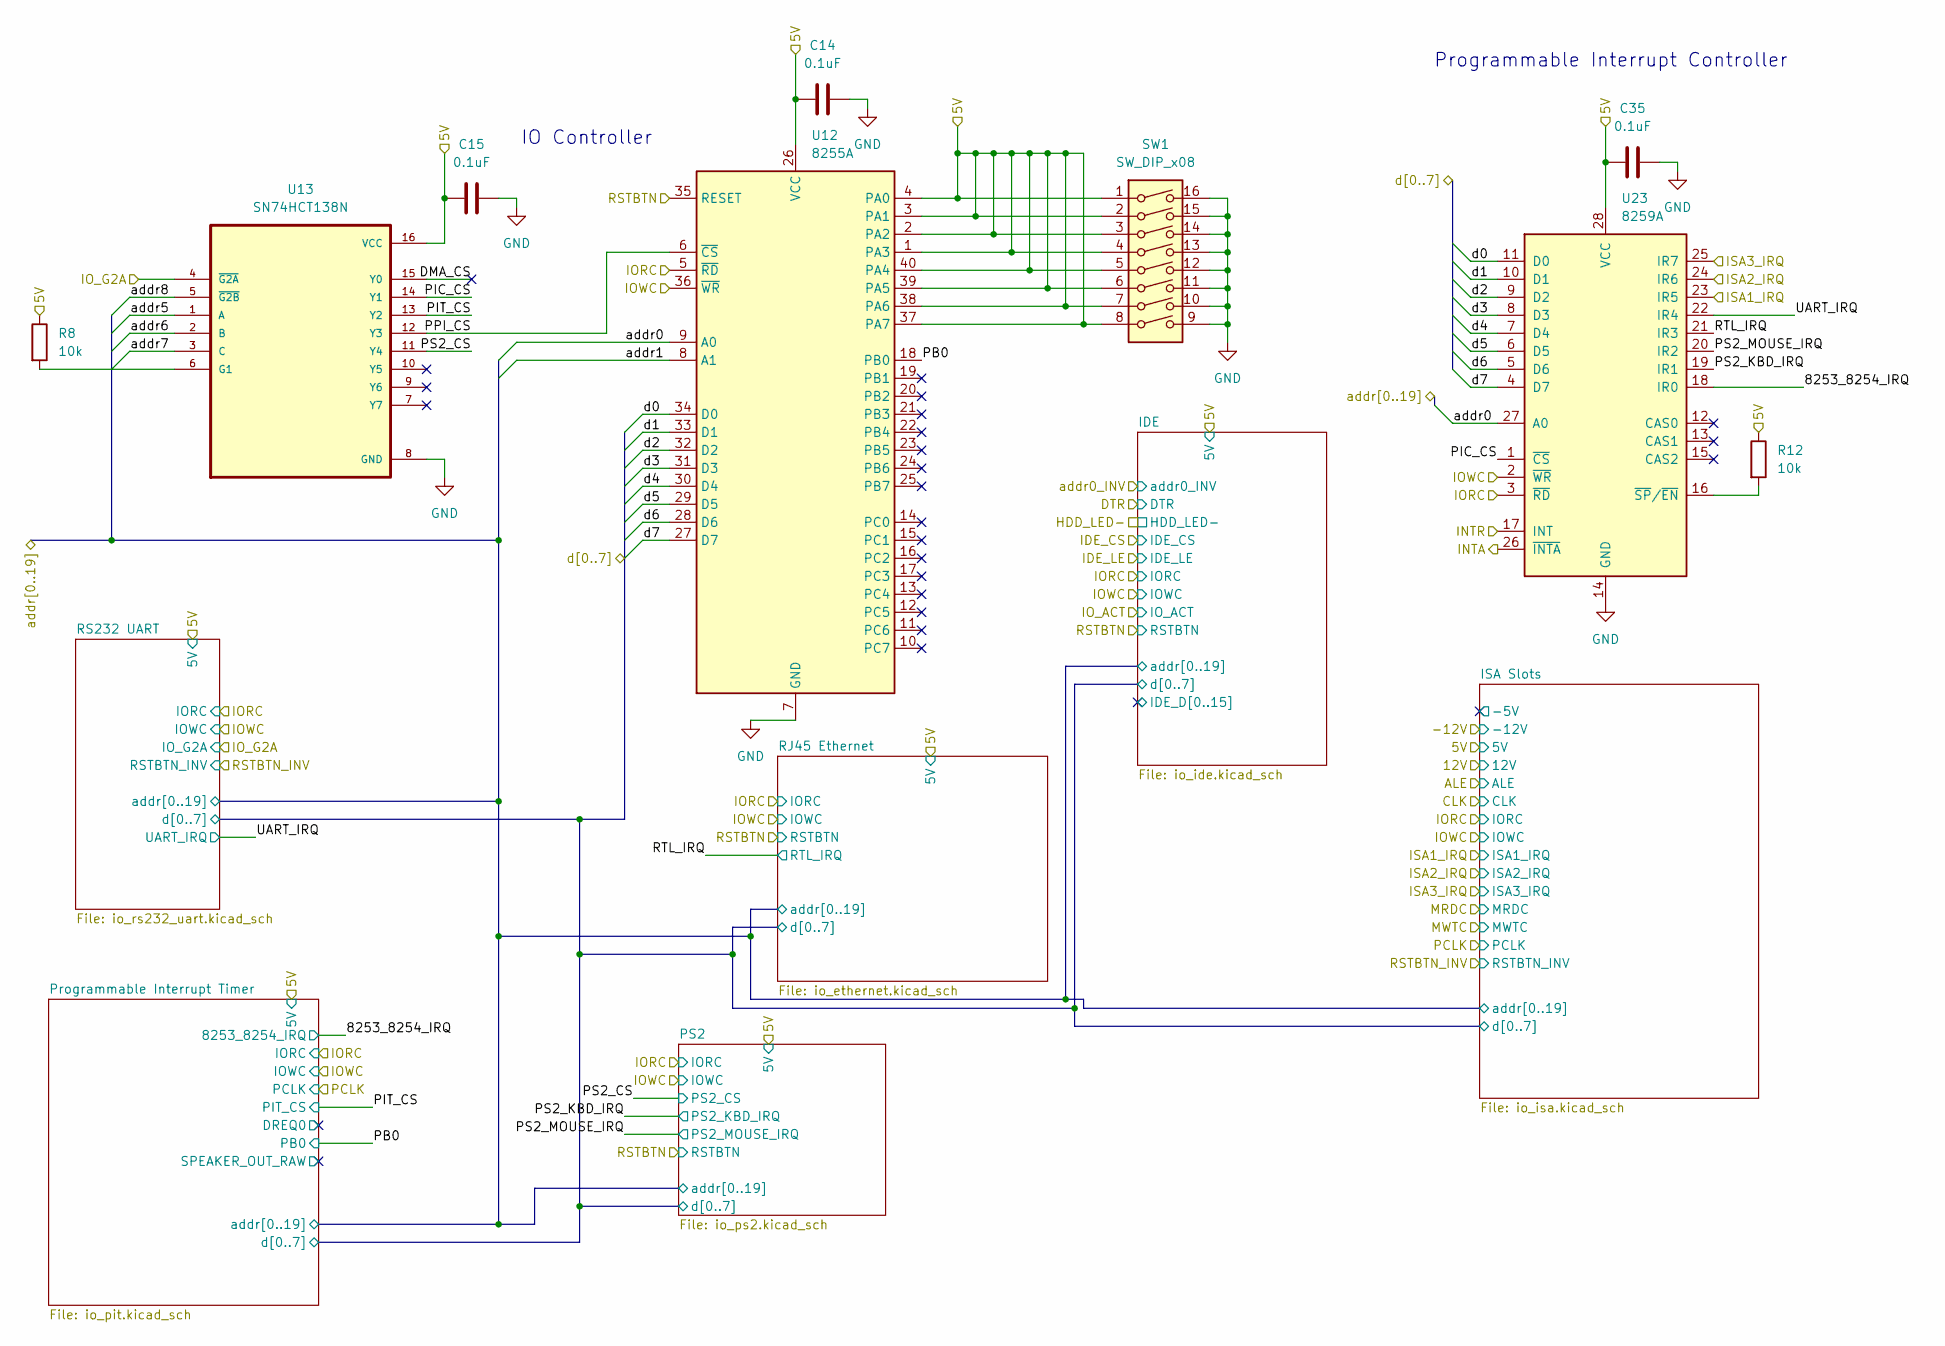
[picture p20: schematic io.kicad_sch, ${TITLE}]

Parts:
C14, C15, C35: 0.1uF; C_Disc_D3.0mm_W1.6mm_P2.50mm
R8, R12: 10k; R_Axial_DIN0204_L3.6mm_D1.6mm_P5.08mm_Horizontal
SW1: SW_DIP_x08; SW_DIP_SPSTx08_Piano_10.8x21.88mm_W7.62mm_P2.54mm
U12: 8255A; DIP-40_W15.24mm_Socket
U13: SN74HCT138N; DIP794W45P254L1969H508Q16
U23: 8259A; DIP-28_W15.24mm_Socket

Connections:
/5V: C14.1, C15.1, C35.1, R8.1, R12.1, SW1.1, SW1.2, SW1.3, SW1.4, SW1.5, SW1.6, SW1.7, SW1.8, U12.1 (PA3), U12.2 (PA2), U12.3 (PA1), U12.4 (PA0), U12.26 (VCC), U12.37 (PA7), U12.38 (PA6), U12.39 (PA5), U12.40 (PA4), U13.16 (VCC), U23.28 (VCC); also elsewhere on the board
/Compute/addr0: U12.9 (A0), U23.27 (A0); also elsewhere on the board
/Compute/addr1: U12.8 (A1); also elsewhere on the board
/Compute/addr5: U13.1 (A); also elsewhere on the board
/Compute/addr6: U13.2 (B); also elsewhere on the board
/Compute/addr7: U13.3 (C); also elsewhere on the board
/Compute/addr8: U13.5 (~G2B); also elsewhere on the board
/Compute/d0: U12.34 (D0), U23.11 (D0); also elsewhere on the board
/Compute/d1: U12.33 (D1), U23.10 (D1); also elsewhere on the board
/Compute/d2: U12.32 (D2), U23.9 (D2); also elsewhere on the board
/Compute/d3: U12.31 (D3), U23.8 (D3); also elsewhere on the board
/Compute/d4: U12.30 (D4), U23.7 (D4); also elsewhere on the board
/Compute/d5: U12.29 (D5), U23.6 (D5); also elsewhere on the board
/Compute/d6: U12.28 (D6), U23.5 (D6); also elsewhere on the board
/Compute/d7: U12.27 (D7), U23.4 (D7); also elsewhere on the board
/INTA: U23.26 (~INTA); also elsewhere on the board
/INTR: U23.17 (INT); also elsewhere on the board
/IO/8253_8254_IRQ: U23.18 (IR0); also elsewhere on the board
/IO/DMA_CS: U13.15 (Y0)
/IO/ISA1_IRQ: U23.23 (IR5); also elsewhere on the board
/IO/ISA2_IRQ: U23.24 (IR6); also elsewhere on the board
/IO/ISA3_IRQ: U23.25 (IR7); also elsewhere on the board
/IO/PB0: U12.18 (PB0); also elsewhere on the board
/IO/PIC_CS: U13.14 (Y1), U23.1 (~CS)
/IO/PIT_CS: U13.13 (Y2); also elsewhere on the board
/IO/PPI_CS: U12.6 (~CS), U13.12 (Y3)
/IO/PS2_CS: U13.11 (Y4); also elsewhere on the board
/IO/PS2_KBD_IRQ: U23.19 (IR1); also elsewhere on the board
/IO/PS2_MOUSE_IRQ: U23.20 (IR2); also elsewhere on the board
/IO/RTL_IRQ: U23.21 (IR3); also elsewhere on the board
/IO/UART_IRQ: U23.22 (IR4); also elsewhere on the board
/IORC: U12.5 (~RD), U23.3 (~RD); also elsewhere on the board
/IOWC: U12.36 (~WR), U23.2 (~WR); also elsewhere on the board
/IO_G2A: U13.4 (~G2A); also elsewhere on the board
/RSTBTN: U12.35 (RESET); also elsewhere on the board
GND: C14.2, C15.2, C35.2, SW1.9, SW1.10, SW1.11, SW1.12, SW1.13, SW1.14, SW1.15, SW1.16, U12.7 (GND), U13.8 (GND), U23.14 (GND); also elsewhere on the board
unnamed: R8.2, U13.6 (G1)
unnamed: R12.2, U23.16 (~SP/~EN)

Notes on the sheet:
Programmable Interrupt Controller
IO Controller

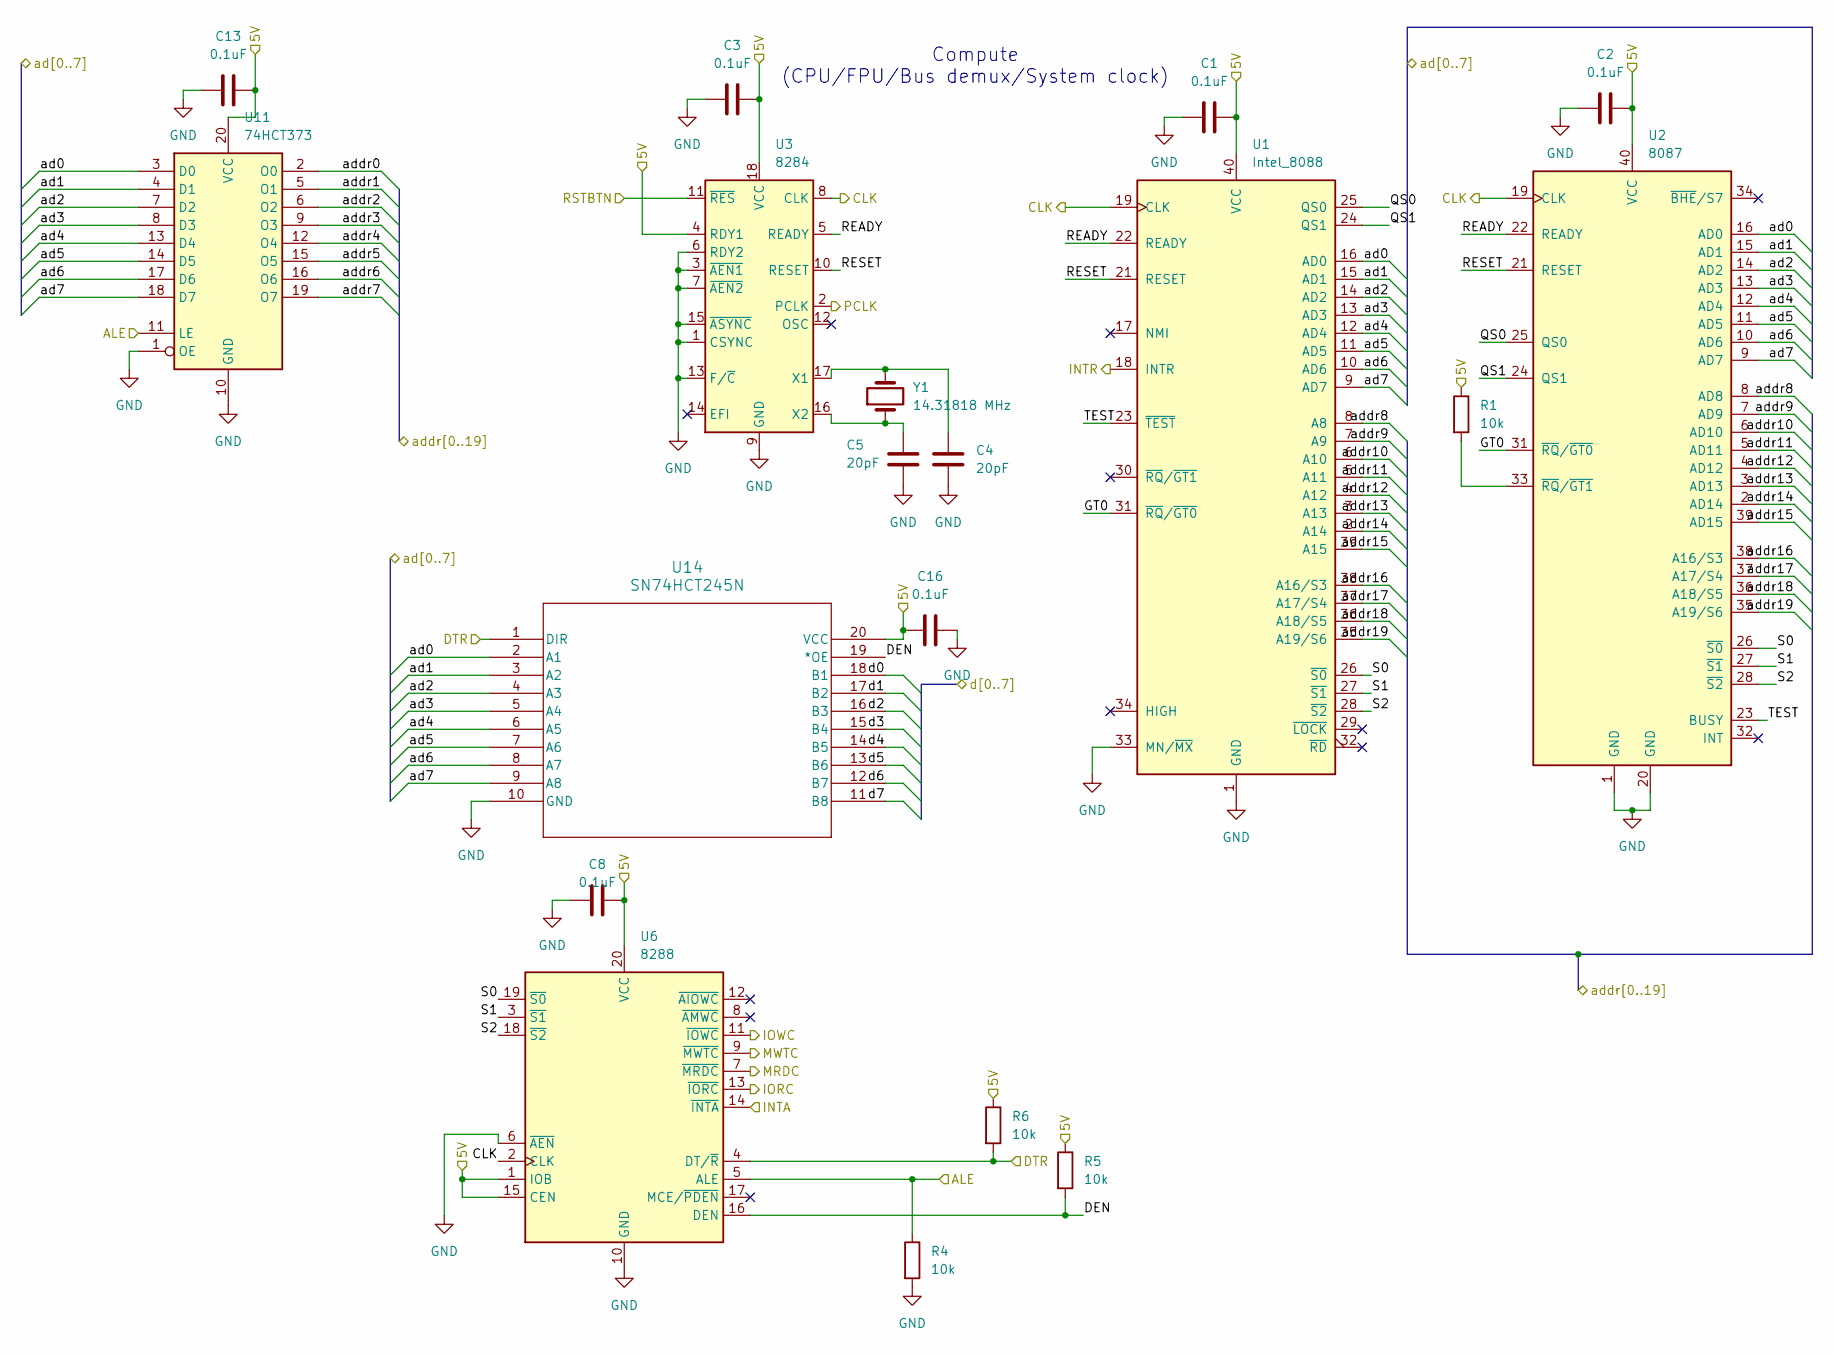
[picture p21: schematic cpu.kicad_sch, ${TITLE}]

Parts:
C1, C2, C3, C8, C13, C16: 0.1uF; C_Disc_D3.0mm_W1.6mm_P2.50mm
C4, C5: 20pF; C_Disc_D3.0mm_W1.6mm_P2.50mm
R1, R4, R5, R6: 10k; R_Axial_DIN0204_L3.6mm_D1.6mm_P5.08mm_Horizontal
U1: Intel_8088; DIP-40_W15.24mm_Socket
U2: 8087; DIP-40_W15.24mm_Socket
U3: 8284; DIP-18_W7.62mm_Socket
U6: 8288; DIP-20_W7.62mm_Socket
U11: 74HCT373; DIP-20_W7.62mm_Socket
U14: SN74HCT245N
Y1: 14.31818 MHz; Crystal_HC49-U_Vertical

Connections:
/5V: C1.2, C2.2, C3.2, C8.2, C13.2, C16.2, R1.1, R5.1, R6.1, U1.40 (VCC), U2.40 (VCC), U3.4 (RDY1), U3.18 (VCC), U6.1 (IOB), U6.15 (CEN), U6.20 (VCC), U11.20 (VCC), U14.20 (VCC); also elsewhere on the board
/ALE: R4.1, U6.5 (ALE), U11.11 (LE); also elsewhere on the board
/CLK: U1.19 (CLK), U2.19 (CLK), U3.8 (CLK), U6.2 (CLK); also elsewhere on the board
/Compute/DEN: R5.2, U6.16 (DEN), U14.19 (*OE)
/Compute/GT0: U1.31 (~RQ/~GT0), U2.31 (~RQ/~GT0)
/Compute/QS0: U1.25 (QS0), U2.25 (QS0)
/Compute/QS1: U1.24 (QS1), U2.24 (QS1)
/Compute/READY: U1.22 (READY), U2.22 (READY), U3.5 (READY)
/Compute/RESET: U1.21 (RESET), U2.21 (RESET), U3.10 (RESET)
/Compute/S0: U1.26 (~S0), U2.26 (~S0), U6.19 (~S0)
/Compute/S1: U1.27 (~S1), U2.27 (~S1), U6.3 (~S1)
/Compute/S2: U1.28 (~S2), U2.28 (~S2), U6.18 (~S2)
/Compute/TEST: U1.23 (~TEST), U2.23 (BUSY)
/Compute/ad0: U1.16 (AD0), U2.16 (AD0), U11.3 (D0), U14.2 (A1)
/Compute/ad1: U1.15 (AD1), U2.15 (AD1), U11.4 (D1), U14.3 (A2)
/Compute/ad2: U1.14 (AD2), U2.14 (AD2), U11.7 (D2), U14.4 (A3)
/Compute/ad3: U1.13 (AD3), U2.13 (AD3), U11.8 (D3), U14.5 (A4)
/Compute/ad4: U1.12 (AD4), U2.12 (AD4), U11.13 (D4), U14.6 (A5)
/Compute/ad5: U1.11 (AD5), U2.11 (AD5), U11.14 (D5), U14.7 (A6)
/Compute/ad6: U1.10 (AD6), U2.10 (AD6), U11.17 (D6), U14.8 (A7)
/Compute/ad7: U1.9 (AD7), U2.9 (AD7), U11.18 (D7), U14.9 (A8)
/Compute/addr0: U11.2 (O0); also elsewhere on the board
/Compute/addr1: U11.5 (O1); also elsewhere on the board
/Compute/addr2: U11.6 (O2); also elsewhere on the board
/Compute/addr3: U11.9 (O3); also elsewhere on the board
/Compute/addr4: U11.12 (O4); also elsewhere on the board
/Compute/addr5: U11.15 (O5); also elsewhere on the board
/Compute/addr6: U11.16 (O6); also elsewhere on the board
/Compute/addr7: U11.19 (O7); also elsewhere on the board
/Compute/addr8: U1.8 (A8), U2.8 (AD8); also elsewhere on the board
/Compute/addr9: U1.7 (A9), U2.7 (AD9); also elsewhere on the board
/Compute/addr10: U1.6 (A10), U2.6 (AD10); also elsewhere on the board
/Compute/addr11: U1.5 (A11), U2.5 (AD11); also elsewhere on the board
/Compute/addr12: U1.4 (A12), U2.4 (AD12); also elsewhere on the board
/Compute/addr13: U1.3 (A13), U2.3 (AD13); also elsewhere on the board
/Compute/addr14: U1.2 (A14), U2.2 (AD14); also elsewhere on the board
/Compute/addr15: U1.39 (A15), U2.39 (AD15); also elsewhere on the board
/Compute/addr16: U1.38 (A16/S3), U2.38 (A16/S3); also elsewhere on the board
/Compute/addr17: U1.37 (A17/S4), U2.37 (A17/S4); also elsewhere on the board
/Compute/addr18: U1.36 (A18/S5), U2.36 (A18/S5); also elsewhere on the board
/Compute/addr19: U1.35 (A19/S6), U2.35 (A19/S6); also elsewhere on the board
/Compute/d0: U14.18 (B1); also elsewhere on the board
/Compute/d1: U14.17 (B2); also elsewhere on the board
/Compute/d2: U14.16 (B3); also elsewhere on the board
/Compute/d3: U14.15 (B4); also elsewhere on the board
/Compute/d4: U14.14 (B5); also elsewhere on the board
/Compute/d5: U14.13 (B6); also elsewhere on the board
/Compute/d6: U14.12 (B7); also elsewhere on the board
/Compute/d7: U14.11 (B8); also elsewhere on the board
/DTR: R6.2, U6.4 (DT/~R), U14.1 (DIR); also elsewhere on the board
/INTA: U6.14 (~INTA); also elsewhere on the board
/INTR: U1.18 (INTR); also elsewhere on the board
/IORC: U6.13 (~IORC); also elsewhere on the board
/IOWC: U6.11 (~IOWC); also elsewhere on the board
/MRDC: U6.7 (~MRDC); also elsewhere on the board
/MWTC: U6.9 (~MWTC); also elsewhere on the board
/PCLK: U3.2 (PCLK); also elsewhere on the board
/RSTBTN: U3.11 (~RES); also elsewhere on the board
GND: C1.1, C2.1, C3.1, C4.1, C5.2, C8.1, C13.1, C16.1, R4.2, U1.1 (GND), U1.20 (GND), U1.33 (MN/~MX), U2.1 (GND), U2.20 (GND), U3.1 (CSYNC), U3.3 (~AEN1), U3.6 (RDY2), U3.7 (~AEN2), U3.9 (GND), U3.13 (F/~C), U3.15 (~ASYNC), U6.6 (~AEN), U6.10 (GND), U11.1 (OE), U11.10 (GND), U14.10 (GND); also elsewhere on the board
unnamed: R1.2, U2.33 (~RQ/~GT1)
unnamed: C4.2, U3.17 (X1), Y1.2
unnamed: C5.1, U3.16 (X2), Y1.1

Notes on the sheet:
Compute (CPU/FPU/Bus demux/System clock)

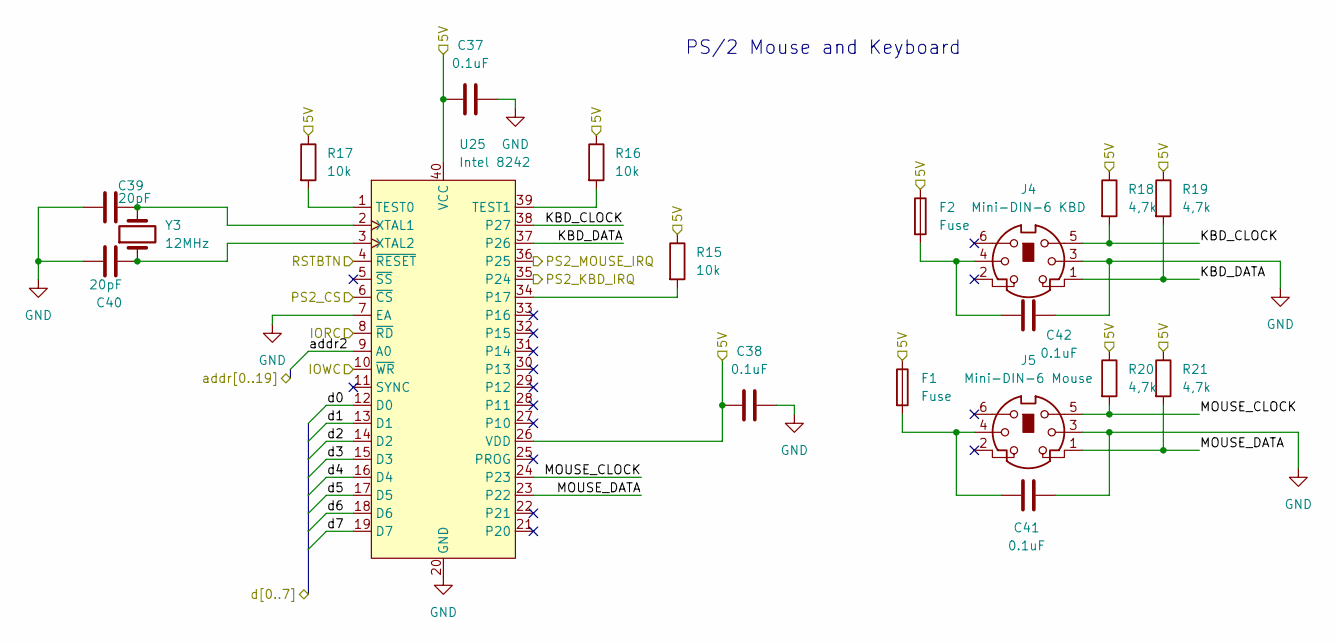
[picture p22: schematic io_ps2.kicad_sch, ${TITLE}]

Parts:
C37, C38, C41, C42: 0.1uF; C_Disc_D3.0mm_W1.6mm_P2.50mm
C39, C40: 20pF; C_Disc_D3.0mm_W1.6mm_P2.50mm
F1, F2: Fuse; Fuseholder_Clip-5x20mm_Eaton_1A5601-01_Inline_P20.80x6.76mm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
J4: Mini-DIN-6 KBD; minidin_6_ps2_pcb_mount
J5: Mini-DIN-6 Mouse; minidin_6_ps2_pcb_mount
R15, R16, R17: 10k; R_Axial_DIN0204_L3.6mm_D1.6mm_P5.08mm_Horizontal
R18, R19, R20, R21: 4,7k; R_Axial_DIN0204_L3.6mm_D1.6mm_P5.08mm_Horizontal
U25: Intel 8242; DIP-40_W15.24mm_Socket
Y3: 12MHz; Crystal_HC49-U_Vertical

Connections:
/5V: C37.1, C38.1, F1.1, F2.1, R15.1, R16.1, R17.1, R18.1, R19.1, R20.1, R21.1, U25.26 (VDD), U25.40 (VCC); also elsewhere on the board
/Compute/addr2: U25.9 (A0); also elsewhere on the board
/Compute/d0: U25.12 (D0); also elsewhere on the board
/Compute/d1: U25.13 (D1); also elsewhere on the board
/Compute/d2: U25.14 (D2); also elsewhere on the board
/Compute/d3: U25.15 (D3); also elsewhere on the board
/Compute/d4: U25.16 (D4); also elsewhere on the board
/Compute/d5: U25.17 (D5); also elsewhere on the board
/Compute/d6: U25.18 (D6); also elsewhere on the board
/Compute/d7: U25.19 (D7); also elsewhere on the board
/IO/PS2/KBD_CLOCK: J4.5, R18.2, U25.38 (P27)
/IO/PS2/KBD_DATA: J4.1, R19.2, U25.37 (P26)
/IO/PS2/MOUSE_CLOCK: J5.5, R20.2, U25.24 (P23)
/IO/PS2/MOUSE_DATA: J5.1, R21.2, U25.23 (P22)
/IO/PS2_CS: U25.6 (~CS); also elsewhere on the board
/IO/PS2_KBD_IRQ: U25.35 (P24); also elsewhere on the board
/IO/PS2_MOUSE_IRQ: U25.36 (P25); also elsewhere on the board
/IORC: U25.8 (~RD); also elsewhere on the board
/IOWC: U25.10 (~WR); also elsewhere on the board
/RSTBTN: U25.4 (~RESET); also elsewhere on the board
GND: C37.2, C38.2, C39.1, C40.1, C41.1, C42.1, J4.3, J5.3, U25.7 (EA), U25.20 (GND); also elsewhere on the board
unnamed: C41.2, F1.2, J5.4
unnamed: C42.2, F2.2, J4.4
unnamed: R15.2, U25.34 (P17)
unnamed: R17.2, U25.1 (TEST0)
unnamed: R16.2, U25.39 (TEST1)
unnamed: C39.2, U25.2 (XTAL1), Y3.2
unnamed: C40.2, U25.3 (XTAL2), Y3.1

Notes on the sheet:
PS/2 Mouse and Keyboard
