Red-Lucy-Engineering/scarlet-8088/scarlet-8088.kicad_pcb

## KiCad design scarlet-8088.kicad_pcb (continued)

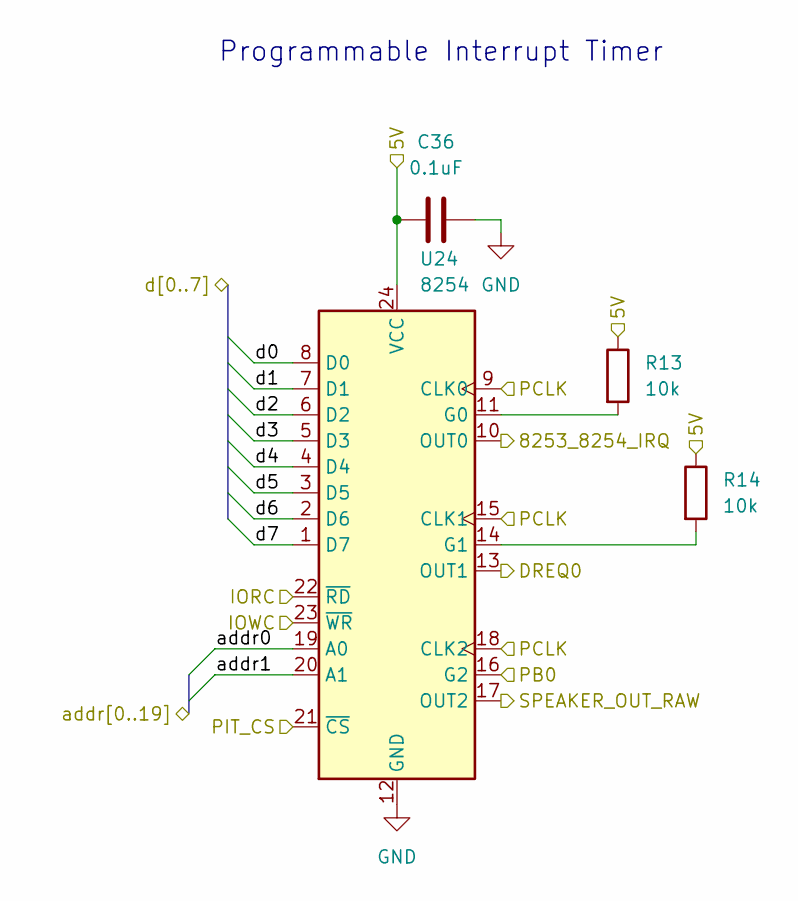
[picture p23: schematic io_pit.kicad_sch, ${TITLE}]

Parts:
C36: 0.1uF; C_Disc_D3.0mm_W1.6mm_P2.50mm
R13, R14: 10k; R_Axial_DIN0204_L3.6mm_D1.6mm_P5.08mm_Horizontal
U24: 8254; DIP-24_W15.24mm_Socket

Connections:
/5V: C36.1, R13.1, R14.1, U24.24 (VCC); also elsewhere on the board
/Compute/addr0: U24.19 (A0); also elsewhere on the board
/Compute/addr1: U24.20 (A1); also elsewhere on the board
/Compute/d0: U24.8 (D0); also elsewhere on the board
/Compute/d1: U24.7 (D1); also elsewhere on the board
/Compute/d2: U24.6 (D2); also elsewhere on the board
/Compute/d3: U24.5 (D3); also elsewhere on the board
/Compute/d4: U24.4 (D4); also elsewhere on the board
/Compute/d5: U24.3 (D5); also elsewhere on the board
/Compute/d6: U24.2 (D6); also elsewhere on the board
/Compute/d7: U24.1 (D7); also elsewhere on the board
/IO/8253_8254_IRQ: U24.10 (OUT0); also elsewhere on the board
/IO/PB0: U24.16 (G2); also elsewhere on the board
/IO/PIT_CS: U24.21 (~CS); also elsewhere on the board
/IO/Programmable Interrupt Timer/DREQ0: U24.13 (OUT1)
/IO/Programmable Interrupt Timer/SPEAKER_OUT_RAW: U24.17 (OUT2)
/IORC: U24.22 (~RD); also elsewhere on the board
/IOWC: U24.23 (~WR); also elsewhere on the board
/PCLK: U24.9 (CLK0), U24.15 (CLK1), U24.18 (CLK2); also elsewhere on the board
GND: C36.2, U24.12 (GND); also elsewhere on the board
unnamed: R13.2, U24.11 (G0)
unnamed: R14.2, U24.14 (G1)

Notes on the sheet:
Programmable Interrupt Timer

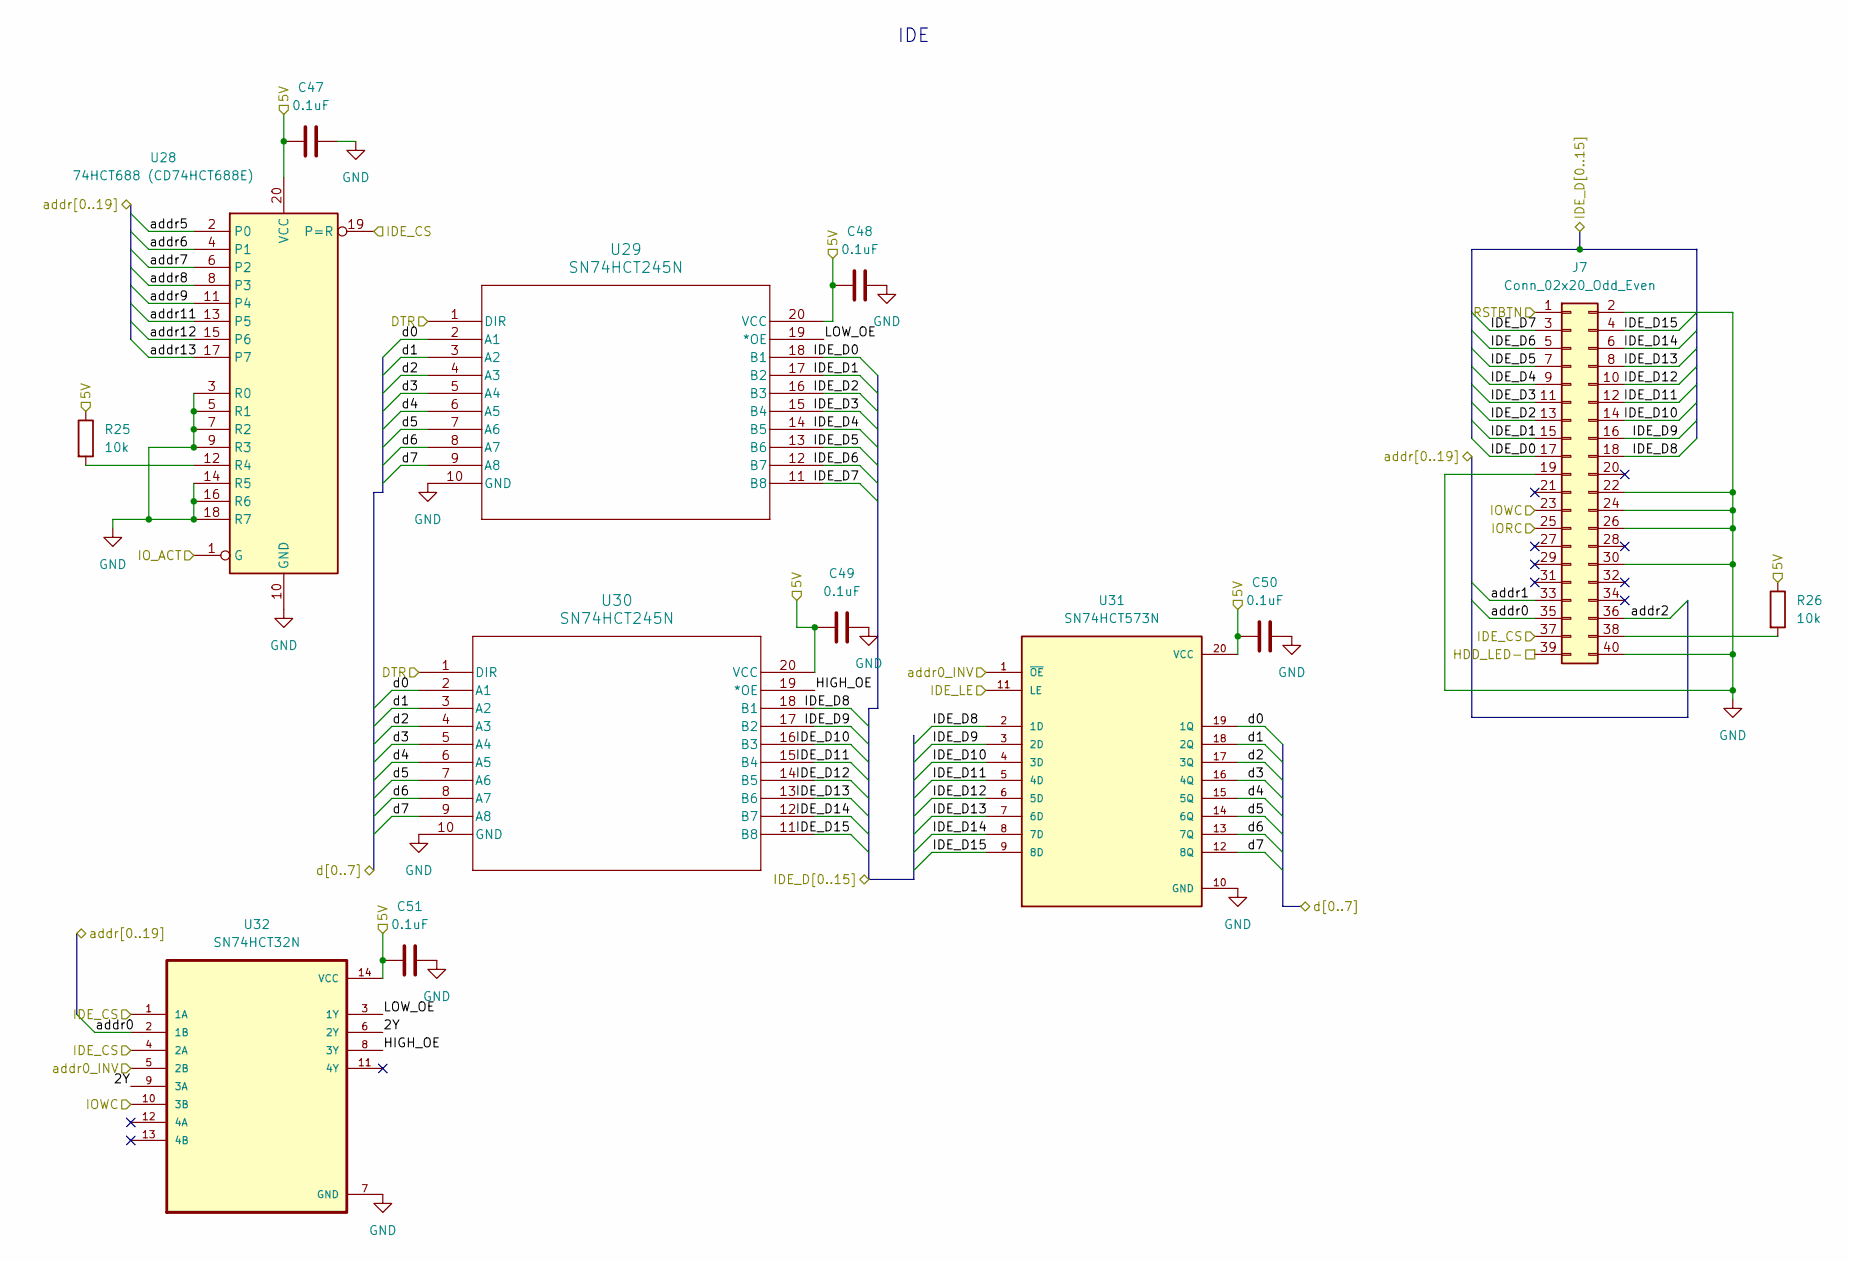
[picture p24: schematic io_ide.kicad_sch, ${TITLE}]

Parts:
C47, C48, C49, C50, C51: 0.1uF; C_Disc_D3.0mm_W1.6mm_P2.50mm
J7: Conn_02x20_Odd_Even; IDC-Header_2x20_P2.54mm_Vertical
R25, R26: 10k; R_Axial_DIN0204_L3.6mm_D1.6mm_P5.08mm_Horizontal
U28: 74HCT688 (CD74HCT688E); DIP-20_W7.62mm_Socket
U29, U30: SN74HCT245N
U31: SN74HCT573N; DIP794W45P254L2540H508Q20; PARTREV F
U32: SN74HCT32N; DIP794W45P254L1969H508Q14

Connections:
/5V: C47.1, C48.1, C49.1, C50.1, C51.1, R25.1, R26.1, U28.20 (VCC), U29.20 (VCC), U30.20 (VCC), U31.20 (VCC), U32.14 (VCC); also elsewhere on the board
/Compute/addr0: J7.35, U32.2 (1B); also elsewhere on the board
/Compute/addr1: J7.33; also elsewhere on the board
/Compute/addr2: J7.36; also elsewhere on the board
/Compute/addr5: U28.2 (P0); also elsewhere on the board
/Compute/addr6: U28.4 (P1); also elsewhere on the board
/Compute/addr7: U28.6 (P2); also elsewhere on the board
/Compute/addr8: U28.8 (P3); also elsewhere on the board
/Compute/addr9: U28.11 (P4); also elsewhere on the board
/Compute/addr11: U28.13 (P5); also elsewhere on the board
/Compute/addr12: U28.15 (P6); also elsewhere on the board
/Compute/addr13: U28.17 (P7); also elsewhere on the board
/Compute/d0: U29.2 (A1), U30.2 (A1), U31.19 (1Q); also elsewhere on the board
/Compute/d1: U29.3 (A2), U30.3 (A2), U31.18 (2Q); also elsewhere on the board
/Compute/d2: U29.4 (A3), U30.4 (A3), U31.17 (3Q); also elsewhere on the board
/Compute/d3: U29.5 (A4), U30.5 (A4), U31.16 (4Q); also elsewhere on the board
/Compute/d4: U29.6 (A5), U30.6 (A5), U31.15 (5Q); also elsewhere on the board
/Compute/d5: U29.7 (A6), U30.7 (A6), U31.14 (6Q); also elsewhere on the board
/Compute/d6: U29.8 (A7), U30.8 (A7), U31.13 (7Q); also elsewhere on the board
/Compute/d7: U29.9 (A8), U30.9 (A8), U31.12 (8Q); also elsewhere on the board
/DTR: U29.1 (DIR), U30.1 (DIR); also elsewhere on the board
/HDD_LED-: J7.39; also elsewhere on the board
/IDE_CS: J7.37, U28.19 (P=R), U32.1 (1A), U32.4 (2A); also elsewhere on the board
/IDE_LE: U31.11 (LE); also elsewhere on the board
/IO/IDE/2Y: U32.6 (2Y), U32.9 (3A)
/IO/IDE/HIGH_OE: U30.19 (*OE), U32.8 (3Y)
/IO/IDE/IDE_D0: J7.17, U29.18 (B1)
/IO/IDE/IDE_D1: J7.15, U29.17 (B2)
/IO/IDE/IDE_D2: J7.13, U29.16 (B3)
/IO/IDE/IDE_D3: J7.11, U29.15 (B4)
/IO/IDE/IDE_D4: J7.9, U29.14 (B5)
/IO/IDE/IDE_D5: J7.7, U29.13 (B6)
/IO/IDE/IDE_D6: J7.5, U29.12 (B7)
/IO/IDE/IDE_D7: J7.3, U29.11 (B8)
/IO/IDE/IDE_D8: J7.18, U30.18 (B1), U31.2 (1D)
/IO/IDE/IDE_D9: J7.16, U30.17 (B2), U31.3 (2D)
/IO/IDE/IDE_D10: J7.14, U30.16 (B3), U31.4 (3D)
/IO/IDE/IDE_D11: J7.12, U30.15 (B4), U31.5 (4D)
/IO/IDE/IDE_D12: J7.10, U30.14 (B5), U31.6 (5D)
/IO/IDE/IDE_D13: J7.8, U30.13 (B6), U31.7 (6D)
/IO/IDE/IDE_D14: J7.6, U30.12 (B7), U31.8 (7D)
/IO/IDE/IDE_D15: J7.4, U30.11 (B8), U31.9 (8D)
/IO/IDE/LOW_OE: U29.19 (*OE), U32.3 (1Y)
/IORC: J7.25; also elsewhere on the board
/IOWC: J7.23, U32.10 (3B); also elsewhere on the board
/IO_ACT: U28.1 (G); also elsewhere on the board
/RSTBTN: J7.1; also elsewhere on the board
/addr0_INV: U31.1 (~OE), U32.5 (2B); also elsewhere on the board
GND: C47.2, C48.2, C49.2, C50.2, C51.2, J7.2, J7.19, J7.22, J7.24, J7.26, J7.30, J7.40, U28.3 (R0), U28.5 (R1), U28.7 (R2), U28.9 (R3), U28.10 (GND), U28.14 (R5), U28.16 (R6), U28.18 (R7), U29.10 (GND), U30.10 (GND), U31.10 (GND), U32.7 (GND); also elsewhere on the board
unnamed: J7.38, R26.2
unnamed: R25.2, U28.12 (R4)

Notes on the sheet:
IDE

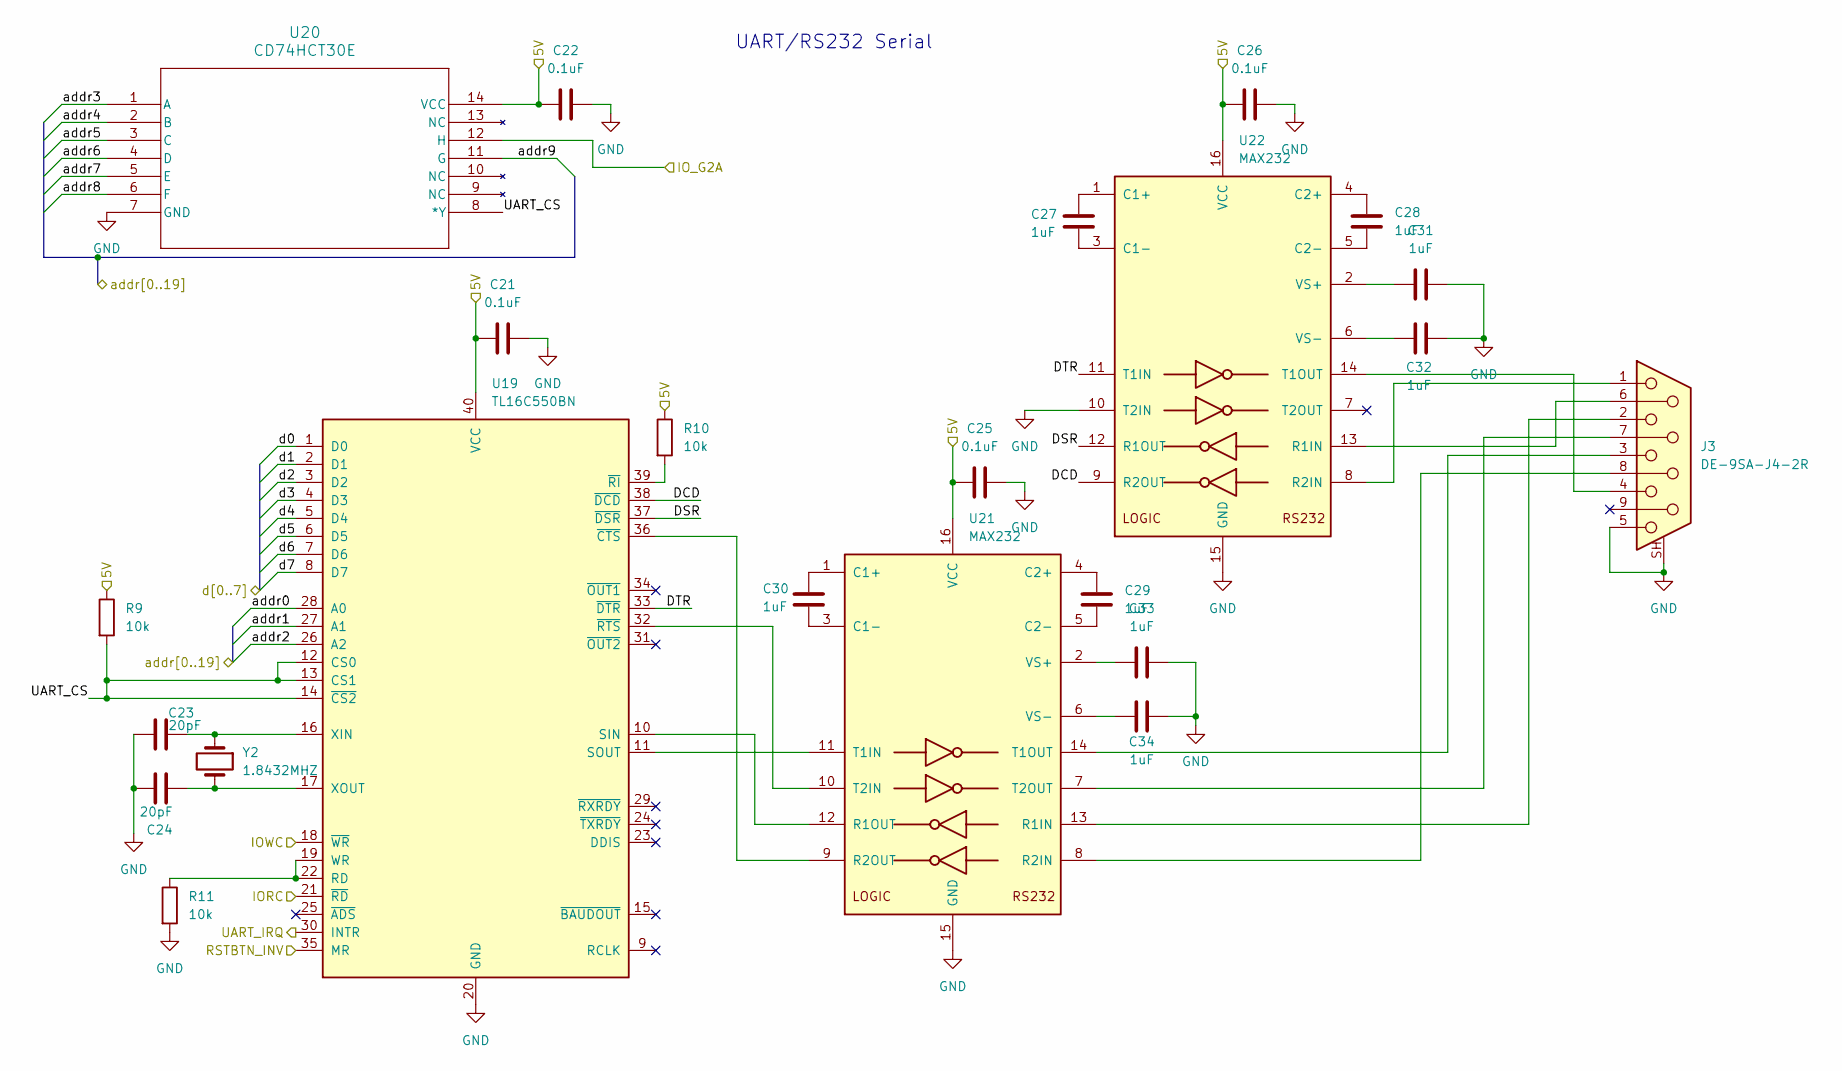
[picture p25: schematic io_rs232_uart.kicad_sch, ${TITLE}]

Parts:
C21, C22, C25, C26: 0.1uF; C_Disc_D3.0mm_W1.6mm_P2.50mm
C23, C24: 20pF; C_Disc_D3.0mm_W1.6mm_P2.50mm
C27, C28, C29, C30, C31, C32, C33, C34: 1uF; C_Disc_D3.0mm_W1.6mm_P2.50mm
J3: DE-9SA-J4-2R; DSUB-9_Socket_Horizontal_P2.77x2.84mm_EdgePinOffset7.70mm_H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
R9, R10, R11: 10k; R_Axial_DIN0204_L3.6mm_D1.6mm_P5.08mm_Horizontal
U19: TL16C550BN; DIP-40_W15.24mm_Socket
U20: CD74HCT30E; N14
U21, U22: MAX232; DIP-16_W7.62mm_Socket
Y2: 1.8432MHZ; Crystal_HC49-U_Vertical

Connections:
/5V: C21.1, C22.1, C25.1, C26.1, R9.1, R10.1, U19.40 (VCC), U20.14 (VCC), U21.16 (VCC), U22.16 (VCC); also elsewhere on the board
/Compute/addr0: U19.28 (A0); also elsewhere on the board
/Compute/addr1: U19.27 (A1); also elsewhere on the board
/Compute/addr2: U19.26 (A2); also elsewhere on the board
/Compute/addr3: U20.1 (A); also elsewhere on the board
/Compute/addr4: U20.2 (B); also elsewhere on the board
/Compute/addr5: U20.3 (C); also elsewhere on the board
/Compute/addr6: U20.4 (D); also elsewhere on the board
/Compute/addr7: U20.5 (E); also elsewhere on the board
/Compute/addr8: U20.6 (F); also elsewhere on the board
/Compute/addr9: U20.11 (G); also elsewhere on the board
/Compute/d0: U19.1 (D0); also elsewhere on the board
/Compute/d1: U19.2 (D1); also elsewhere on the board
/Compute/d2: U19.3 (D2); also elsewhere on the board
/Compute/d3: U19.4 (D3); also elsewhere on the board
/Compute/d4: U19.5 (D4); also elsewhere on the board
/Compute/d5: U19.6 (D5); also elsewhere on the board
/Compute/d6: U19.7 (D6); also elsewhere on the board
/Compute/d7: U19.8 (D7); also elsewhere on the board
/IO/RS232 UART/DCD: U19.38 (~DCD), U22.9 (R2OUT)
/IO/RS232 UART/DSR: U19.37 (~DSR), U22.12 (R1OUT)
/IO/RS232 UART/DTR: U19.33 (~DTR), U22.11 (T1IN)
/IO/RS232 UART/UART_CS: R9.2, U19.12 (CS0), U19.13 (CS1), U19.14 (~CS2), U20.8 (*Y)
/IO/UART_IRQ: U19.30 (INTR); also elsewhere on the board
/IORC: U19.21 (~RD); also elsewhere on the board
/IOWC: U19.18 (~WR); also elsewhere on the board
/IO_G2A: U20.12 (H); also elsewhere on the board
/RSTBTN_INV: U19.35 (MR); also elsewhere on the board
GND: C21.2, C22.2, C23.1, C24.1, C25.2, C26.2, C31.1, C32.1, C33.1, C34.1, J3.5, J3.SH (PAD), R11.2, U19.20 (GND), U20.7 (GND), U21.15 (GND), U22.10 (T2IN), U22.15 (GND); also elsewhere on the board
unnamed: R11.1, U19.19 (WR), U19.22 (RD)
unnamed: U19.10 (SIN), U21.12 (R1OUT)
unnamed: U19.11 (SOUT), U21.11 (T1IN)
unnamed: C23.2, U19.16 (XIN), Y2.1
unnamed: C24.2, U19.17 (XOUT), Y2.2
unnamed: U19.36 (~CTS), U21.9 (R2OUT)
unnamed: R10.2, U19.39 (~RI)
unnamed: U19.32 (~RTS), U21.10 (T2IN)
unnamed: C30.2, U21.1 (C1+)
unnamed: C30.1, U21.3 (C1-)
unnamed: C29.2, U21.4 (C2+)
unnamed: C29.1, U21.5 (C2-)
unnamed: J3.2, U21.13 (R1IN)
unnamed: J3.8, U21.8 (R2IN)
unnamed: J3.3, U21.14 (T1OUT)
unnamed: J3.7, U21.7 (T2OUT)
unnamed: C33.2, U21.2 (VS+)
unnamed: C34.2, U21.6 (VS-)
unnamed: C27.2, U22.1 (C1+)
unnamed: C27.1, U22.3 (C1-)
unnamed: C28.2, U22.4 (C2+)
unnamed: C28.1, U22.5 (C2-)
unnamed: J3.6, U22.13 (R1IN)
unnamed: J3.1, U22.8 (R2IN)
unnamed: J3.4, U22.14 (T1OUT)
unnamed: C31.2, U22.2 (VS+)
unnamed: C32.2, U22.6 (VS-)

Notes on the sheet:
UART/RS232 Serial

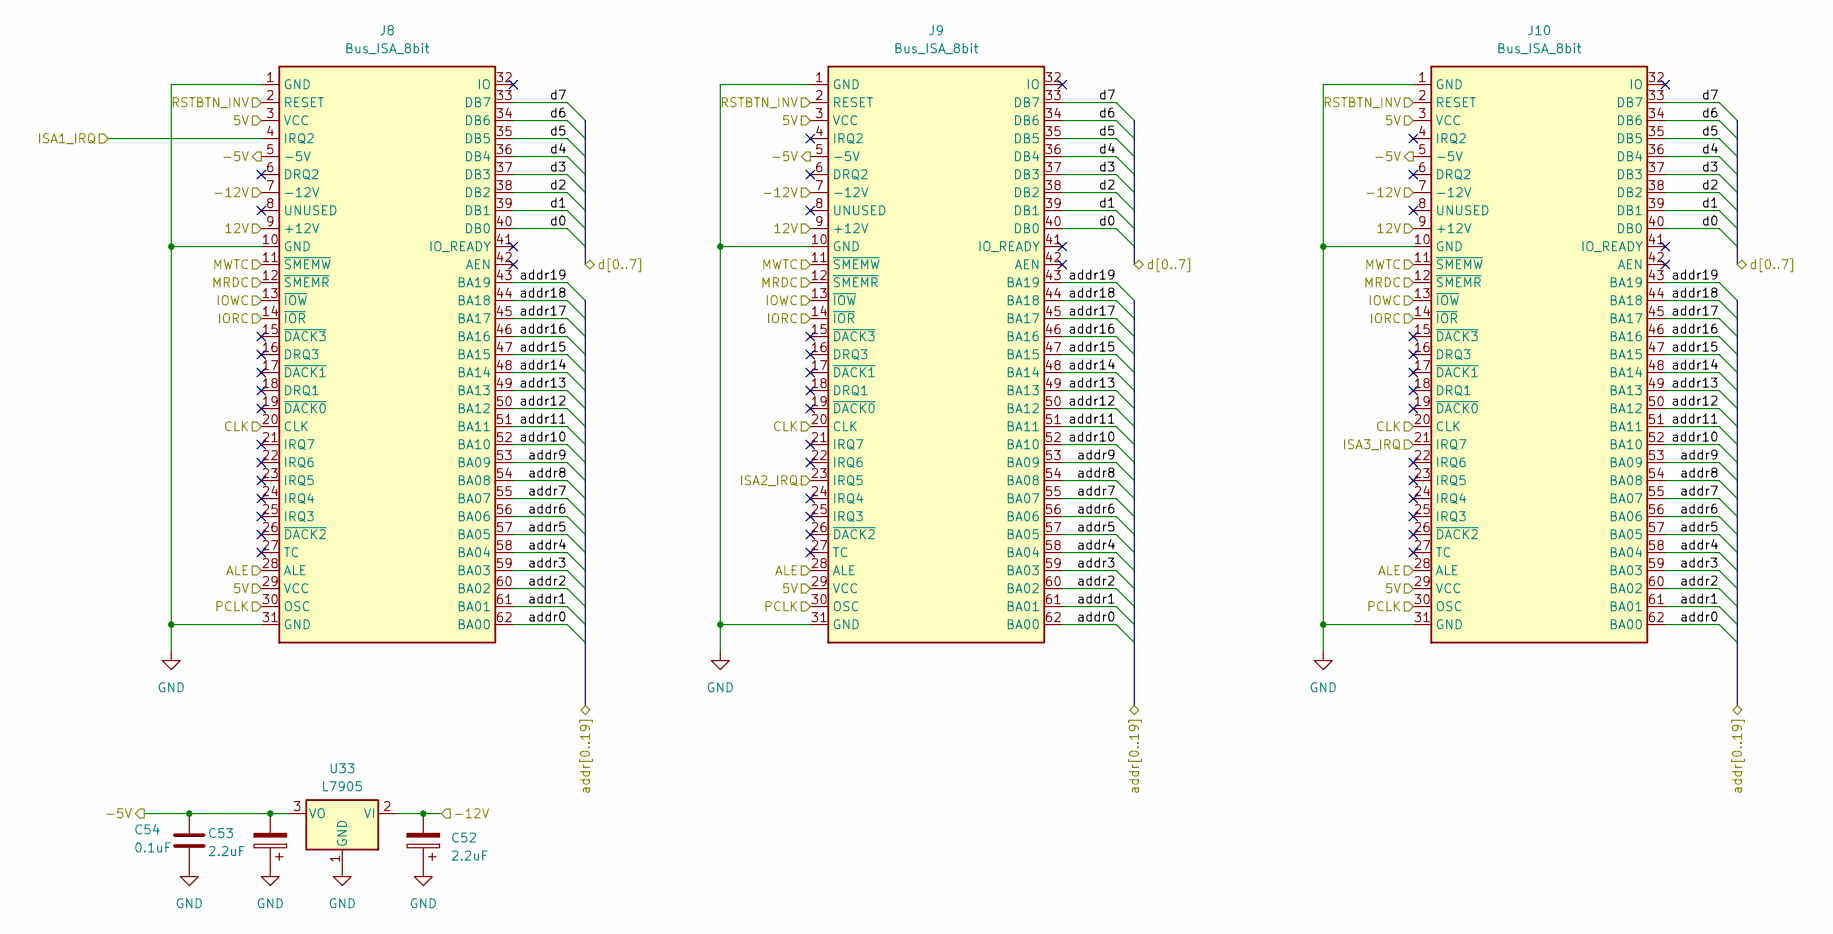
[picture p26: schematic io_isa.kicad_sch, ${TITLE}]

Parts:
C52, C53: 2.2uF; CP_Radial_D10.0mm_P2.50mm
C54: 0.1uF; C_Disc_D3.0mm_W1.6mm_P2.50mm
J8, J9, J10: Bus_ISA_8bit; PinSocket_2x31_P2.54mm_Vertical
U33: L7905; TO-220-3_Vertical

Connections:
/5V: J8.3 (VCC), J8.29 (VCC), J9.3 (VCC), J9.29 (VCC), J10.3 (VCC), J10.29 (VCC); also elsewhere on the board
/12V: J8.9 (+12V), J9.9 (+12V), J10.9 (+12V); also elsewhere on the board
/-12V: C52.2, J8.7 (-12V), J9.7 (-12V), J10.7 (-12V), U33.2 (VI); also elsewhere on the board
/ALE: J8.28 (ALE), J9.28 (ALE), J10.28 (ALE); also elsewhere on the board
/CLK: J8.20 (CLK), J9.20 (CLK), J10.20 (CLK); also elsewhere on the board
/Compute/addr0: J8.62 (BA00), J9.62 (BA00), J10.62 (BA00); also elsewhere on the board
/Compute/addr1: J8.61 (BA01), J9.61 (BA01), J10.61 (BA01); also elsewhere on the board
/Compute/addr2: J8.60 (BA02), J9.60 (BA02), J10.60 (BA02); also elsewhere on the board
/Compute/addr3: J8.59 (BA03), J9.59 (BA03), J10.59 (BA03); also elsewhere on the board
/Compute/addr4: J8.58 (BA04), J9.58 (BA04), J10.58 (BA04); also elsewhere on the board
/Compute/addr5: J8.57 (BA05), J9.57 (BA05), J10.57 (BA05); also elsewhere on the board
/Compute/addr6: J8.56 (BA06), J9.56 (BA06), J10.56 (BA06); also elsewhere on the board
/Compute/addr7: J8.55 (BA07), J9.55 (BA07), J10.55 (BA07); also elsewhere on the board
/Compute/addr8: J8.54 (BA08), J9.54 (BA08), J10.54 (BA08); also elsewhere on the board
/Compute/addr9: J8.53 (BA09), J9.53 (BA09), J10.53 (BA09); also elsewhere on the board
/Compute/addr10: J8.52 (BA10), J9.52 (BA10), J10.52 (BA10); also elsewhere on the board
/Compute/addr11: J8.51 (BA11), J9.51 (BA11), J10.51 (BA11); also elsewhere on the board
/Compute/addr12: J8.50 (BA12), J9.50 (BA12), J10.50 (BA12); also elsewhere on the board
/Compute/addr13: J8.49 (BA13), J9.49 (BA13), J10.49 (BA13); also elsewhere on the board
/Compute/addr14: J8.48 (BA14), J9.48 (BA14), J10.48 (BA14); also elsewhere on the board
/Compute/addr15: J8.47 (BA15), J9.47 (BA15), J10.47 (BA15); also elsewhere on the board
/Compute/addr16: J8.46 (BA16), J9.46 (BA16), J10.46 (BA16); also elsewhere on the board
/Compute/addr17: J8.45 (BA17), J9.45 (BA17), J10.45 (BA17); also elsewhere on the board
/Compute/addr18: J8.44 (BA18), J9.44 (BA18), J10.44 (BA18); also elsewhere on the board
/Compute/addr19: J8.43 (BA19), J9.43 (BA19), J10.43 (BA19); also elsewhere on the board
/Compute/d0: J8.40 (DB0), J9.40 (DB0), J10.40 (DB0); also elsewhere on the board
/Compute/d1: J8.39 (DB1), J9.39 (DB1), J10.39 (DB1); also elsewhere on the board
/Compute/d2: J8.38 (DB2), J9.38 (DB2), J10.38 (DB2); also elsewhere on the board
/Compute/d3: J8.37 (DB3), J9.37 (DB3), J10.37 (DB3); also elsewhere on the board
/Compute/d4: J8.36 (DB4), J9.36 (DB4), J10.36 (DB4); also elsewhere on the board
/Compute/d5: J8.35 (DB5), J9.35 (DB5), J10.35 (DB5); also elsewhere on the board
/Compute/d6: J8.34 (DB6), J9.34 (DB6), J10.34 (DB6); also elsewhere on the board
/Compute/d7: J8.33 (DB7), J9.33 (DB7), J10.33 (DB7); also elsewhere on the board
/IO/ISA1_IRQ: J8.4 (IRQ2); also elsewhere on the board
/IO/ISA2_IRQ: J9.23 (IRQ5); also elsewhere on the board
/IO/ISA3_IRQ: J10.21 (IRQ7); also elsewhere on the board
/IO/ISA Slots/-5V: C53.2, C54.1, J8.5 (-5V), J9.5 (-5V), J10.5 (-5V), U33.3 (VO)
/IORC: J8.14 (~IOR), J9.14 (~IOR), J10.14 (~IOR); also elsewhere on the board
/IOWC: J8.13 (~IOW), J9.13 (~IOW), J10.13 (~IOW); also elsewhere on the board
/MRDC: J8.12 (~SMEMR), J9.12 (~SMEMR), J10.12 (~SMEMR); also elsewhere on the board
/MWTC: J8.11 (~SMEMW), J9.11 (~SMEMW), J10.11 (~SMEMW); also elsewhere on the board
/PCLK: J8.30 (OSC), J9.30 (OSC), J10.30 (OSC); also elsewhere on the board
/RSTBTN_INV: J8.2 (RESET), J9.2 (RESET), J10.2 (RESET); also elsewhere on the board
GND: C52.1, C53.1, C54.2, J8.1 (GND), J8.10 (GND), J8.31 (GND), J9.1 (GND), J9.10 (GND), J9.31 (GND), J10.1 (GND), J10.10 (GND), J10.31 (GND), U33.1 (GND); also elsewhere on the board

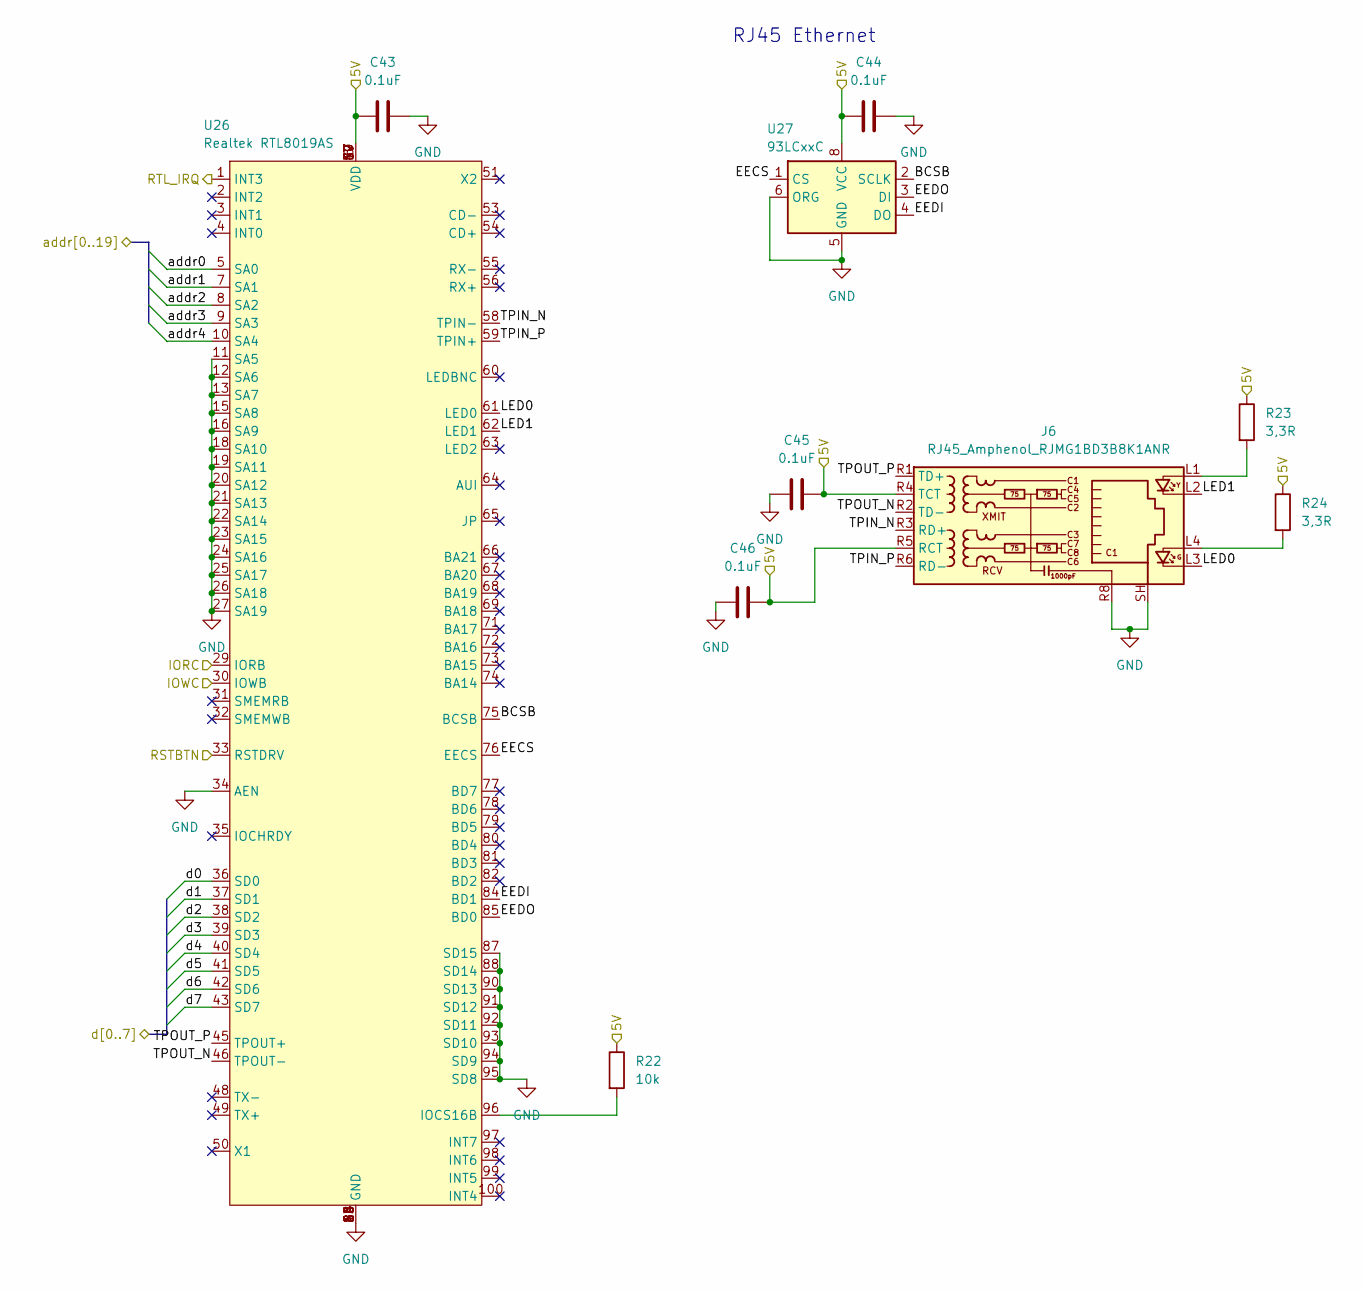
[picture p27: schematic io_ethernet.kicad_sch, ${TITLE}]

Parts:
C43, C44, C45, C46: 0.1uF; C_Disc_D3.0mm_W1.6mm_P2.50mm
J6: RJ45_Amphenol_RJMG1BD3B8K1ANR
R22: 10k; R_Axial_DIN0204_L3.6mm_D1.6mm_P5.08mm_Horizontal
R23, R24: 3,3R; R_Axial_DIN0204_L3.6mm_D1.6mm_P5.08mm_Horizontal
U26: Realtek RTL8019AS; PQFP-100_14x20mm_P0.65mm
U27: 93LCxxC; DIP-8_W7.62mm_Socket

Connections:
/5V: C43.1, C44.1, C45.1, C46.1, J6.R4 (TCT), J6.R5 (RCT), R22.1, R23.1, R24.1, U26.6 (VDD), U26.17 (VDD), U26.47 (VDD), U26.57 (VDD), U26.70 (VDD), U26.89 (VDD), U27.8 (VCC); also elsewhere on the board
/Compute/addr0: U26.5 (SA0); also elsewhere on the board
/Compute/addr1: U26.7 (SA1); also elsewhere on the board
/Compute/addr2: U26.8 (SA2); also elsewhere on the board
/Compute/addr3: U26.9 (SA3); also elsewhere on the board
/Compute/addr4: U26.10 (SA4); also elsewhere on the board
/Compute/d0: U26.36 (SD0); also elsewhere on the board
/Compute/d1: U26.37 (SD1); also elsewhere on the board
/Compute/d2: U26.38 (SD2); also elsewhere on the board
/Compute/d3: U26.39 (SD3); also elsewhere on the board
/Compute/d4: U26.40 (SD4); also elsewhere on the board
/Compute/d5: U26.41 (SD5); also elsewhere on the board
/Compute/d6: U26.42 (SD6); also elsewhere on the board
/Compute/d7: U26.43 (SD7); also elsewhere on the board
/IO/RJ45 Ethernet/BCSB: U26.75 (BCSB), U27.2 (SCLK)
/IO/RJ45 Ethernet/EECS: U26.76 (EECS), U27.1 (CS)
/IO/RJ45 Ethernet/EEDI: U26.84 (BD1), U27.4 (DO)
/IO/RJ45 Ethernet/EEDO: U26.85 (BD0), U27.3 (DI)
/IO/RJ45 Ethernet/LED0: J6.L3, U26.61 (LED0)
/IO/RJ45 Ethernet/LED1: J6.L2, U26.62 (LED1)
/IO/RJ45 Ethernet/TPIN_N: J6.R3 (RD+), U26.58 (TPIN-)
/IO/RJ45 Ethernet/TPIN_P: J6.R6 (RD-), U26.59 (TPIN+)
/IO/RJ45 Ethernet/TPOUT_N: J6.R2 (TD-), U26.46 (TPOUT-)
/IO/RJ45 Ethernet/TPOUT_P: J6.R1 (TD+), U26.45 (TPOUT+)
/IO/RTL_IRQ: U26.1 (INT3); also elsewhere on the board
/IORC: U26.29 (IORB); also elsewhere on the board
/IOWC: U26.30 (IOWB); also elsewhere on the board
/RSTBTN: U26.33 (RSTDRV); also elsewhere on the board
GND: C43.2, C44.2, C45.2, C46.2, J6.R8, J6.SH, U26.11 (SA5), U26.12 (SA6), U26.13 (SA7), U26.14 (GND), U26.15 (SA8), U26.16 (SA9), U26.18 (SA10), U26.19 (SA11), U26.20 (SA12), U26.21 (SA13), U26.22 (SA14), U26.23 (SA15), U26.24 (SA16), U26.25 (SA17), U26.26 (SA18), U26.27 (SA19), U26.28 (GND), U26.34 (AEN), U26.44 (GND), U26.52 (GND), U26.83 (GND), U26.86 (GND), U26.87 (SD15), U26.88 (SD14), U26.90 (SD13), U26.91 (SD12), U26.92 (SD11), U26.93 (SD10), U26.94 (SD9), U26.95 (SD8), U27.5 (GND), U27.6 (ORG); also elsewhere on the board
unnamed: J6.L1, R23.2
unnamed: J6.L4, R24.2
unnamed: R22.2, U26.96 (IOCS16B)

Notes on the sheet:
RJ45 Ethernet

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
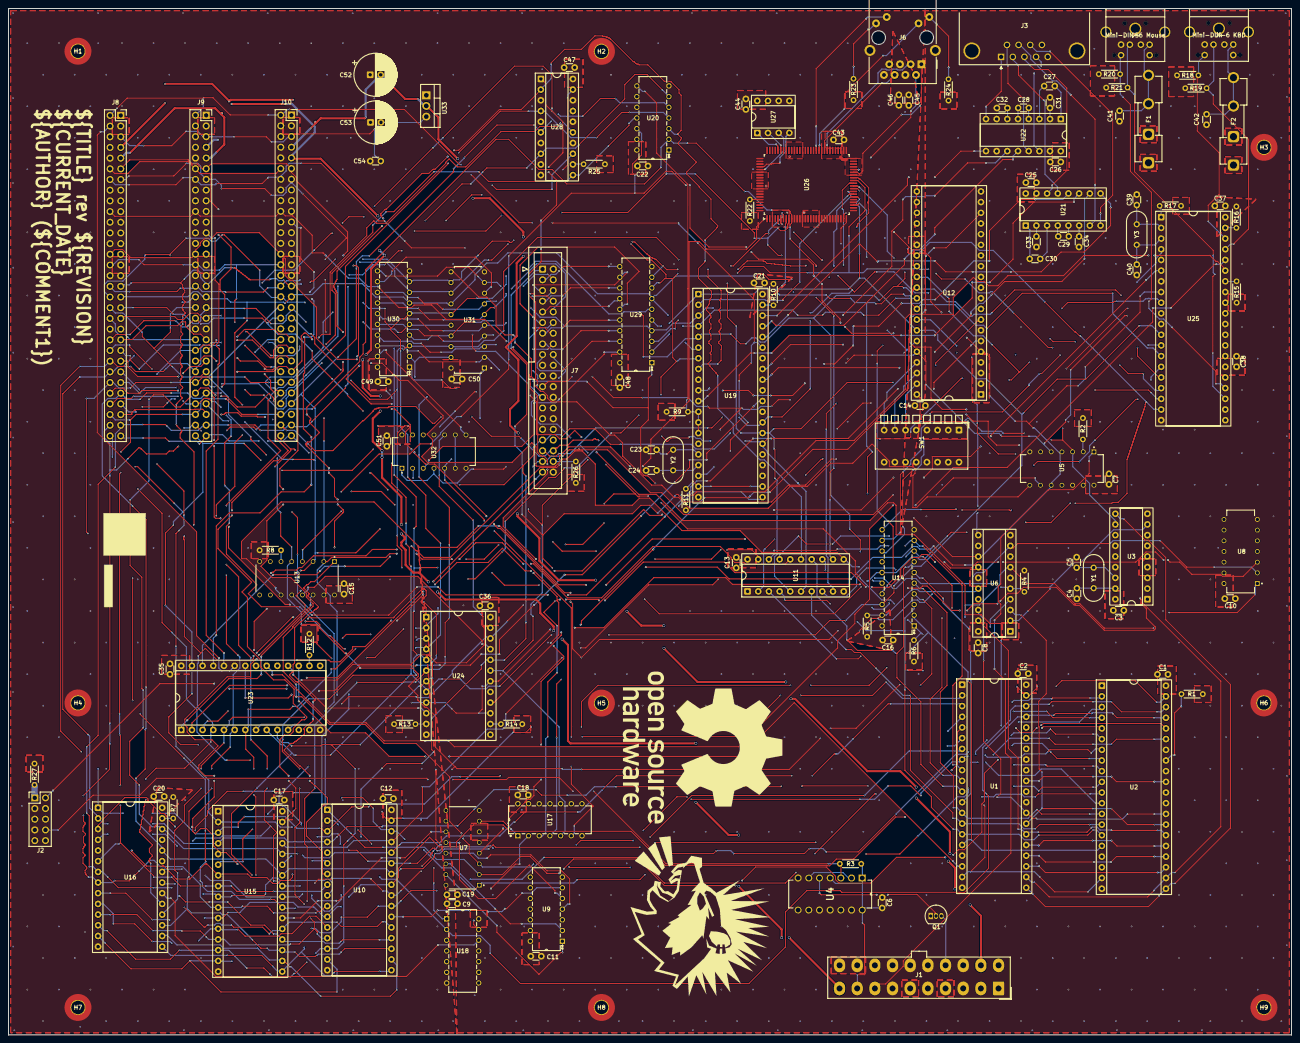
[picture p28: board scarlet-8088.kicad_pcb from above]

Board: 4 copper layers, 305.0 x 244.0 mm, 140 parts (0 on the bottom side), 183 nets.
