Red-Lucy-Engineering/scarlet-8088/(commit log)

2026-09-04 cpu and fpu connected together
    [cpu.kicad_sch, power.kicad_sch, scarlet-8088.kicad_sch]
2026-09-04 power delivery to compute basics
    [cpu.kicad_sch, power.kicad_sch, scarlet-8088.kicad_sch]
2026-09-04 add datsheets
    [cpu.kicad_sch]
2026-09-04 Add Bus 8288 controller
    [cpu.kicad_sch, scarlet-8088.kicad_pcb]
2026-09-06 Add grounded Mounting Holes to schematic
    [scarlet-8088.kicad_pcb, scarlet-8088.kicad_sch]
2026-09-11 Memory mapping for RAM and ROM (BIOS)
    [cpu.kicad_sch, memory.kicad_sch, scarlet-8088.kicad_sch]
2026-09-12 Complete UART connection
    [cpu.kicad_sch, io.kicad_sch, memory.kicad_sch, power.kicad_sch, scarlet-8088.kicad_sch]
2026-09-12 PIC controller added
    [cpu.kicad_sch, io.kicad_sch]
2026-09-12 add PIT
    [cpu.kicad_sch, io.kicad_sch, io_pit.kicad_sch, io_rs232_uart.kicad_sch, scarlet-8088.kicad_sch]
2026-09-13 PS/2 Controller and connections
    [io.kicad_sch, io_ps2.kicad_sch, scarlet-8088.kicad_sch]
2026-09-13 Added compatible RJ45 Ethernet
    [io.kicad_sch, io_ethernet.kicad_sch, io_ps2.kicad_sch, scarlet-8088.kicad_sch]
2026-09-13 IDE controller/connector
    [cpu.kicad_sch, io.kicad_sch, io_ide.kicad_sch, memory.kicad_sch, power.kicad_sch, scarlet-8088.kicad_sch]
2026-09-13 ISA card slots, schematic cleanup
    [cpu.kicad_sch, io.kicad_sch, io_isa.kicad_sch, scarlet-8088.kicad_sch]
2026-09-13 setup for JLCPCB 4-Layers
    [scarlet-8088.kicad_pcb]
2026-09-14 Fix ERC errors
    [cpu.kicad_sch, io.kicad_sch, io_ethernet.kicad_sch, io_ide.kicad_sch, io_isa.kicad_sch, io_pit.kicad_sch, io_ps2.kicad_sch, io_rs232_uart.kicad_sch]
2026-09-14 import all components into PCB editor
    [scarlet-8088.kicad_pcb]
2026-09-15 Place mounting holes according to ATX spec
    [scarlet-8088.kicad_pcb]
2026-09-15 Add rear IO window markings according to ATX spec
    [scarlet-8088.kicad_pcb]
2026-09-15 change Mini-DIN-6 Footprint; Place ISA slots correctly
    [io.kicad_sch, io_ps2.kicad_sch, scarlet-8088.kicad_pcb]
2026-09-15 initial component layout (and fresh schematic export)
    [scarlet-8088.kicad_pcb]
2026-09-19 Reset footprint placement; place Power System footprints
    [Mini-DIN-6P.step, RJMG1BD3B8K1ANR--3DModel-STEP-56544.STEP, scarlet-8088.kicad_pcb]
2026-09-20 place compute block
    [scarlet-8088.kicad_pcb]
2026-09-20 Component placement fully redone
    [scarlet-8088.kicad_pcb]
2026-09-21 use more of the available space for the placement
    [scarlet-8088.kicad_pcb]
2026-09-21 routing, first round
    [scarlet-8088.kicad_pcb]
2026-09-21 Routing rev1.0 finished
    [scarlet-8088.kicad_pcb]
2026-09-21 Move silkscreen text if unreadable
    [scarlet-8088.kicad_pcb]
2026-09-21 add 3d model for all components
    [scarlet-8088.kicad_pcb]
2026-09-21 Add silkscreen graphics and text
    [scarlet-8088.kicad_pcb]
2026-09-21 stitching vias
    [scarlet-8088.kicad_pcb]
2026-09-21 Manufacturing files generated
    [scarlet-8088.kicad_pcb, scarlet-8088_Intel-8088-based_ATX_Motherboard_1.0_bom.csv, scarlet-8088_Intel-8088-based_ATX_Motherboard_1.0_designators.csv, scarlet-8088_Intel-8088-based_ATX_Motherboard_1.0_positions.csv]
